sion1223/temi-tranformation-v2/robotemi_official/Proxy-Launcher/README.md

A proxy app launcher

Supported app

| App | Key | Value |
|---|---|---|
| Chrome | url | "https://www.robotemi.com" |
