sion1223/temi-tranformation-v2/basket/smart_lock_box_r3_lift/HARDWARE_ACCEPTANCE.md

# 실물 확인표

전 항목 **미실행**. CAD 계산을 합격으로 옮겨 적지 않는다.

|시험|확인할 내용|
|---|---|
|구매품 치수|PQ12 양끝 유효위치·핀간격·15mm높이·단자·케이블; MGN7C 홀피치; LM6UU; L6D 3kg 납품도면|
|모터 내부 수용|닫힘·승강 전 구간에서 모터·단자·케이블·관절이 케이스 밖으로 나가지 않음|
|조립 정렬|네롤러 동시 접촉, 레일·수직축 평행, 어느 위치에서도 구속/틀어짐 없음|
|빈판/500g|평균 전류·기동 전류·왕복시간·온도·완전하강·완전상승. 센서가 실제로 스톨 전에 종료시킴|
|편하중|종이500g 중앙 및4모서리·프레임처짐·가이드 마찰·바닥 수평|
|전원상실|어느 높이에서도 예기치 않은 급강하 여부, 정지상태 유지. 단전시 손으로 밑을 받치지 않고 별도 기계 지지로 정비|
|과부하·끼임|전류제한·6초시간제한·요청해제시 정지·한쪽스위치만 감지·안전한 수동 회수|
|센서 고장|UP/DOWN단선·단락·I2C정지·FAULT·리셋·저전압·통신단절에서 승강/주행 금지|
|계량|하강안착/모터OFF후3초,5g분동9지점×10회, A4한장 반복,30분영점드리프트|
|가드·배선|종이·손·케이블이 램프/가이드에 닿지 않음, 계량판에 케이블 당김 없음, 보호판 고정나사 접근|
|듀티|제조사20% 이하,최대6초ON이면24초이상OFF. 실제 발열·시간 기록|
|잠금·도어|R3순서로 개방/격납/닫기; 올라온 바닥 상태에서 닫기 방지|
|테미|108mm케이스와 열림도어의 헤드·시야·센서·주행 간섭,장착강도·전원·최대총중량|

기존 R3 펌웨어는 승강 제어와 이 표의 고장대응이 통합되기 전 실물 자동운전에 사용하지 않는다.
