sion1223/temi-tranformation-v2/basket/smart_lock_box_r3/HARDWARE_ACCEPTANCE.md

# 실물 승인 시험 — 아직 수행하지 않음

이 파일의 빈 항목 또는 `NOT_RUN`을 합격으로 바꾸지 않는다. `hardware_measurements.csv`에 실측값을 기록한다. 현재 결과는 컴퓨터 기하 검사와 소프트웨어 모의 시험까지다.

1. 구매품 치수: L6D 3 kg의 제조사 도면·체결 방향·가동단·M6 피치/나사 길이, 5065 스트로크, 두 레버 스위치, HX711 보드의 실제 AVDD/E+, BLE 공급/신호전압 확인. 도면과 다르면 모델·배선부터 수정한다.
2. 하중 경로: 상판 전체와 라이너/스페이서의 사하중 기록. 상판을 누르지 않을 때 스토퍼와 보호판 모두 비접촉. 가동단 이외에 하중이 전달되는 지점이 없어야 한다. 최대 하중에서 틈을 실측하고 스토퍼 심을 조정한다. 0.8 mm라는 CAD 간격으로 과부하 안전을 판정하지 않는다.
3. 센서 보정: 최소 15초 초기 대기 후 빈 판과 추적 가능한 500 g 분동으로 보정. 케이블/패널 정비, 판 교체, 조립 토크 변경 뒤 재시험한다.
4. 5 g 분동: 판의 중앙, 네 변 중간, 네 모서리 안쪽의 총 9지점에 각 10회 적재·회수. 최소 90회 모두 검출, 회수 후 비적재 복귀. 프레임 평균 무게, 창 내 최대-최소, 지연, 실패를 기록한다. 검출 지연 목표는 정지·안정 조건 충족 후 5초 이내다.
5. 실제 A4 80 g/㎡ 한 장: 실제 질량을 기준 저울로 먼저 측정. 평평한 종이를 판 밖/벽/키퍼에 걸치지 않고 9개 유효 배치(미세 위치 이동)에 각각 10회 적재·회수한다. 90회 모두 검출해야 한다. 종이 구김·말림과 실제 실내 공기 흐름 조건도 별도 확인한다.
6. 빈 판 드리프트: 30분 동안 1초 간격 기록, 종이를 올렸다 내리는 과정 포함. 빈 판이 3 g 임계값에 접근하거나 0.8 g 안정 창을 계속 만족하지 못하면 불합격. 최소 목표는 빈 판 ±1 g 이내, 안정 창 0.8 g 이내. 자동 영점으로 이 실패를 숨기지 않는다.
7. 로봇 진동: 정지 상태에서만 유효 무게를 내며 이동·회전·급정지·도어 조작·솔레노이드 동작 중에는 INVALID. 완전 정지 이후 새 20샘플을 받은 뒤에만 다시 유효. 로봇의 실제 상태를 기반으로 heartbeat를 보낼 앱이 필요하다.
8. 재부팅: A4 한 장을 둔 채 전원 20회 재인가. 보정이 사라지거나 물건을 빈 판으로 잡으면 실패. 키/EEPROM 부팅 번호 저장 중 전압이 떨어져도 이전 인증 응답이 재사용되면 실패. BOD 설정·watchdog 복구를 실제 보드에서 확인한다.
9. 고장 주입: DOUT 단선/단락, 셀 브리지 단선/쇼트, 센서 전원 단절, 리드/레버 단선, 전면 패널 및 보호판 분리, 정지 heartbeat 단절, 인증 변조/재전송. 오류 시 해제 금지·코일 차단·무효 무게·이동 시작 거부를 확인한다. 모든 종류의 로드셀 브리지 고장이 자동 검출된다고 가정하지 않는다.
10. 잠금·닫기: 무전원 잠김 확인. 전진 스위치가 정상이어도 키퍼에 실제 물림이 없으면 불합격. 명령 후 500 ms 안에 후퇴, 후퇴 간격 ≥0.3 mm, 명령 닫기 후 전진·문 닫힘 동시 확인. 스프링 캠에 의존한 강제 닫힘은 승인하지 않는다. 명시한 목표 인장하중을 먼저 결정하고 100회 이상의 잠금/해제 및 인장 시험을 실시한다.
11. 코일·전원: 전류 제한된 12 V로 시작. 2초 ON/6초 OFF 반복 시 코일/드라이버/배선 온도, 5 V/HX711 잡음, 최저 입력에서 후퇴력을 측정. 퓨즈는 코일 과열 보호기가 아니다. Timer1/WDT, MCU 정지, 전원 재부팅 후 최소 휴지시간도 실제 확인한다.
12. 테미 장착: 폭 증가 12 mm, 총중량, 격납 돌출 174.2 mm, 헤드의 모든 자세, 체결판·케이블·수동 서비스 해제 접근을 검사. 현재 로봇 장착 좌표와 헤드 모델이 연결돼 있지 않아 CAD 합격 범위에 포함하지 않았다.

최대 적재 무게, 목표 잠금 인장하중, 배터리 자립 시간은 사용자 미정 사항이다. 이 셋을 정하지 않은 채 제조 승인이나 성능 보증을 하지 않는다.
