sion1223/temi-tranformation-v2/.sites-design-options/option-a.html

temi Head 3D Library

모델 준비됨

공유 링크 ⓘ

↻ ✥ ⌕ ⌗ ◩

PERSPECTIVE · SHADED1 unit = 1 mm · Z-UP

Head_2.0.33 / 전체 조립체선택: Main Head Shell · 148,290 faces

XYZ

LMB회전SHIFT이동SCROLL확대

Assembly navigator

## 부품 탐색기

12개 메시

⌕

▼Head_2.0.33ASSEMBLY · 12 PARTS◉

Main Head ShellOBJ · 148,290 FACES◉

Face Screen BezelOBJ · 32,144 FACES◉

▶Side Sensor HousingGROUP · 2 PARTS◉

Sensor Ring — LSTL · 8,432 FACES◉

Sensor Ring — RSTL · 8,432 FACES◉

Lower Chin CoverOBJ · 19,608 FACES◉

Neck AdapterSTL · 24,190 FACES◉

Top PlateSTL · 11,076 FACES◉

Main Head Shell선택됨

크기286 × 248 × 224 mm

용량18.42 MB

버텍스74,208

형식Wavefront OBJ

선택 부품 다운로드 ↓

### 원본 제작 파일

Blender와 3D 프린팅 도구에서 바로 열 수 있는
검증된 원본 파일입니다.

OBJ

Reference AssemblyBlender 조립체 · 163.37 MB

↓

STL

All Components전체 출력 부품 · 81.99 MB

↓

3MF

Bambu Printfile슬라이서 프로젝트 · 22.33 MB

↓
