sion1223/temi-tranformation-v2/.sites-design-options/option-b.html

temi HEAD LIBRARYOPEN HARDWARE ARCHIVE

HEAD α2.0.33 · ASSEMBLY 001
UPDATED 2026.07.21 / KR

Interactive component archive / 01—33

# temi Head 3D Library

로봇 헤드를 부품 단위로 살펴보세요.드래그하여 회전하고, 메시를 선택해 숨기거나 개별 다운로드할 수 있습니다. 원본 제작 파일도 그대로 제공합니다.

부품 목록 18

부품 이름 검색

01외부 쉘 02전면 센서 링 03카메라 하우징 04좌측 스피커 커버 05우측 스피커 커버 06하단 턱 플레이트 07넥 마운트 08내부 브래킷 A 09내부 브래킷 B

전체 표시18 / 18

솔리드와이어분해도

PERSPECTIVE · FRONT 3/4

드래그 회전휠 확대클릭 선택

선택 항목 02 / 18

MESH_002

### 전면 센서 링

재질ABS / BLACK크기Ø 84 mm폴리곤12,480파일STL · 3.8 MB

메시 표시

선택 강조

치수 가이드

선택 부품 다운로드 ↓

PART FILTER전체 18외장 6센서 3구조 5마운트 4● 3D 미리보기 준비됨

Original source

## 전체 모델 다운로드

제작자가 제공한 원본 파일입니다.
라이선스 및 버전 정보를 확인하세요.

OBJ

REFERENCE ASSEMBLY

### 원본 조립 모델

163.37 MB · Blender 호환

↓

STL

ALL COMPONENTS

### 전체 출력 부품

81.99 MB · Binary STL

↓

3MF

BAMBU PRINT FILE

### 프린트 프로젝트

22.33 MB · Bambu Studio

↓

다운로드 준비 중입니다.
