sion1223/temi-tranformation-v2/.sites-design-options/option-c.html

temiHEAD 3D LIBRARY

● WEBGL READYKR⌄

Digital Artifact / 033

# HEADARCHIVE

On display

temi Head Assembly
Alpha 2.0.33

REF_ASSEMBLY_OBJ

구성 요소18 MESHES

정점2,481,903

스케일1:1 / mm

↻✥＋⌗

원본 파일03 FILES

OBJReference Assembly163.37 MB · 조립 원본↓ STLAll Components81.99 MB · 프린트 메시↓ 3MFBambu Printfile22.33 MB · 슬라이서 프로젝트↓

선택한 부품 다운로드 ↓

CURRENT SELECTION

### Face Frame Assembly

FACE_FRAME_A · 14.82 MB

단독 보기정보 열기

DRAG TO ROTATE · SCROLL TO ZOOM · SHIFT + DRAG TO PAN

부품 인벤토리 18

전체외장프레임브래킷전자부품

패널 접기⌄

01 / SELECTED

Face Frame

FACE_FRAME_A

◉

02

Side Frame L

SIDE_FRAME_L

◉

03

Top Cover

TOP_COVER_01

◉

04

Camera Mount

CAM_MOUNT_B

◉

05

Neck Bracket

NECK_BRKT_02

◉

06

Rear Shell

REAR_SHELL_C

◉
