sion1223/temi-tranformation-v2/temi robotemi GitHub 비개발자 설명서.docx

처음 보는 사람을 위한 현장 안내서

robotemi GitHub, 이렇게 보면 됩니다

프로그래밍 언어를 몰라도 프로젝트의 구조·준비물·진행 순서를 이해하는 설명서

기준일: 2026년 7월 16일

대상: 프로젝트 책임자, 교사, 운영자, 입문자

공식 기준: robotemi GitHub / SDK 1.138.0

# 이 설명서로 할 수 있는 것

- GitHub 화면에서 무엇을 눌러야 하는지 구분할 수 있다.
- robotemi의 5개 저장소 중 우리 프로젝트에 필요한 것을 고를 수 있다.
- 개발자에게 무엇을 요청하고 무엇을 확인해야 하는지 알 수 있다.
- 샘플 앱을 로봇에서 실행하는 전체 순서를 이해할 수 있다.
- 실패했을 때 버전·연결·권한·Kiosk 중 어디를 먼저 볼지 판단할 수 있다.

중요 이 문서는 코드를 직접 작성하는 교재가 아니라, 공식 예제를 안전하게 실행하고 개발자와 같은 그림을 보도록 돕는 운영 안내서다.

# 1. GitHub가 무엇인가요?

GitHub는 프로그램의 설계도, 설명서, 변경 기록을 함께 보관하는 온라인 작업실이다. robotemi 링크는 temi 제조사가 공개한 공식 개발 자료 모음이다.

화면의 말 | 쉬운 뜻 | 여기서 할 일
Repository | 한 프로젝트의 자료함 | sdk 저장소를 연다
README | 첫 안내문 | 목적·버전을 확인한다
Code | 프로그램 파일 | 직접 수정은 개발자에게 맡긴다
Wiki | 사용 설명서 | 설치·음성·이동·권한을 읽는다
Release | 버전별 변경 기록 | 로봇 Launcher와 맞는지 본다
Sample | 작동 예제 | 처음부터 새로 만들지 말고 기준으로 삼는다
Issue | 질문·오류 게시판 | 공식 문서에 없는 현상을 검색한다
Clone/Download | 자료를 내 컴퓨터로 복사 | 개발자가 프로젝트를 내려받는다

# 2. robotemi 저장소 5개 이해하기

이름 | 비유 | 우리 프로젝트에서
sdk | 로봇 운전면허+설명서 | 반드시 사용. 이동·말하기·듣기·상태 확인
sample-app-media | 카메라/마이크 실습실 | 미디어 기능이 필요한 단계에서 참고
temi-Go | 배송 서비스 완성 예 | 서류함 목적지 배정·도착 화면 참고
Proxy-Launcher | 다른 앱을 여는 리모컨 | 현재는 필요 없음
TemiGoProSDK | Temi-Go-Pro 전용 리모컨 | 해당 장치가 있을 때만 사용

한 줄 결론 처음에는 sdk의 README·Wiki·sample 세 곳만 보면 된다. 나머지는 기능이 필요해졌을 때 연다.

# 3. 이 프로젝트가 실제로 어떻게 움직이나요?

1. 방문객이 화면의 '말하기' 버튼을 누르거나 로봇을 깨운다.
2. temi가 말을 듣고 글자로 바꾼다.
3. 글자가 Jetson이라는 작은 AI 컴퓨터로 전달된다.
4. Jetson이 직원 목록에서 사람과 방을 찾고, 필요하면 외부 AI에 질문한다.
5. Jetson이 '행정실 앞'처럼 미리 승인된 장소 이름을 temi 앱에 돌려준다.
6. temi가 안내 문장을 말하고 저장된 장소로 이동한다.
7. 담당자에게 방문 알림을 보낸다.

안전 장치 AI가 임의의 좌표를 만들게 하지 않는다. 로봇에 미리 저장된 장소 이름 중에서만 선택하게 한다.

# 4. 시작 전에 확인할 것

확인 항목 | 어디서 확인? | 기록 예
temi 기종 | 제품 라벨/설정 | V2 또는 V3
Launcher 버전 | temi 설정의 시스템 정보 | 138 / 빌드 19627 이상
Wi‑Fi | temi와 PC 네트워크 | 같은 공유기
개발 PC | Windows/Mac | Android Studio 설치 가능
권한 | 설정→Developer Tools | ADB Port Opening 가능
안전 공간 | 사람 없는 시험 구역 | 정지 버튼 담당자 지정

공식 Wiki 기준으로 temi V2는 Android 6.0.1(API 23), V3는 Android 11(API 30)이다. 같은 앱이라도 카메라·마이크·권한 반응이 다를 수 있으므로 기종을 반드시 기록한다.

# 5. 샘플 앱을 로봇에서 실행하는 순서

## 5.1 개발자에게 준비를 요청하세요

8. Android Studio와 ADB(Android Debug Bridge)를 PC에 설치한다.
9. https://github.com/robotemi/sdk 에서 Code → Download ZIP 또는 git clone으로 자료를 받는다.
10. Android Studio에서 sdk 폴더를 프로젝트로 연다.
11. README에 적힌 SDK 버전 1.138.0을 사용하도록 확인한다.
12. Gradle 동기화가 끝날 때까지 기다리고 sample 모듈을 빌드한다.

## 5.2 temi와 PC를 연결하세요

13. temi와 PC를 같은 Wi‑Fi에 연결한다.
14. temi에서 Settings → temi Developer Tools → ADB Port Opening을 누른다.
15. 화면에 표시된 temi의 IP 주소를 적는다.
16. PC의 터미널/명령 프롬프트에서 adb connect <IP주소>:5555를 실행한다.
17. Android Studio의 실행 장치에 rockchip rk... 또는 temi가 보이는지 확인한다.
18. sample 앱을 Run으로 실행한다.

성공 화면 temi의 앱 목록에 샘플 앱 이름이 보이고, 앱을 열었을 때 버튼이 나타나면 1차 성공이다.

# 6. 앱이 temi 앱 목록에 보이게 하는 표시

개발자는 AndroidManifest.xml이라는 앱 신분증에 SKILL 메타데이터를 넣어야 한다. 이것은 '이 앱을 temi 앱 목록에 보여 주세요'라는 표지다.

<meta-data android:name="com.robotemi.sdk.metadata.SKILL" android:value="@string/app_name" />

운영자는 코드를 외울 필요가 없다. 다만 앱이 목록에 없을 때 개발자에게 'Manifest의 SKILL 메타데이터와 onRobotReady 처리를 확인해 주세요'라고 요청하면 된다.

# 7. 장소를 준비하고 이동을 시험하는 법

19. temi 기본 기능으로 지도를 만들고 home base를 설정한다.
20. 복도·회의실 앞·행정실 앞처럼 실제 멈출 지점을 저장한다.
21. 장소 이름은 짧고 중복 없이 정한다. 예: '행정실 앞', '회의실 A'.
22. 샘플 앱에서 저장된 위치 목록이 보이는지 확인한다.
23. 사람 없는 곳에서 가장 느린 속도로 한 장소씩 goTo를 시험한다.
24. 이동 중 화면에 상태가 표시되고, 정지 버튼이 즉시 작동하는지 확인한다.
25. 20회 시험 결과를 기록한다. 실패하면 장소 이름, 시간, 장애물, 오류 상태를 함께 적는다.

하지 말 것 첫 시험에서 후진, 최고 속도, 혼잡한 복도, 임의 좌표 이동을 사용하지 않는다.

# 8. 듣기·말하기 기능을 이해하는 법

기능 | 쉬운 뜻 | 공식 SDK에서
Wakeup | 듣기 시작 | 앱이 wakeup()을 호출할 수 있음
ASR/STT | 음성을 글자로 변환 | AsrListener로 결과를 받음
NLU/LLM | 문장의 뜻을 판단 | 기본 기능 또는 Jetson AI 사용
TTS | 글을 음성으로 읽기 | speak() 또는 별도 TTS 서비스
Conversation status | 듣는 중/생각 중/말하는 중 | 화면 상태 표시용

기존 계획처럼 처음부터 마이크를 직접 녹음할 필요는 없다. 먼저 공식 wakeup→ASR→speak 흐름을 시험한다. 실제 로비 소음에서 품질이 부족할 때만 외부 STT/TTS로 교체한다.

# 9. Kiosk Mode는 무엇인가요?

Kiosk Mode는 우리 앱을 temi의 기본 홈 화면으로 지정하는 기능이다. 앱이 계속 앞에 있어야 하거나, temi의 기본 음성 흐름을 바꿔야 할 때 사용한다.

26. 개발자가 Manifest에 KIOSK=true를 선언한다.
27. 앱을 설치하고 실행한다.
28. temi Settings → Home Screen/Application 또는 Kiosk 메뉴로 이동한다.
29. 우리 앱을 선택하고 Kiosk를 켠다.
30. 앱에서 Kiosk 선택 여부와 켜짐 상태를 확인한다.
31. 운영자는 반드시 Kiosk 해제 방법을 먼저 연습한다.

주의 Kiosk는 앱에 더 큰 제어 권한을 준다. 시험용 앱을 운영 로봇의 기본 앱으로 바로 지정하지 않는다.

# 10. Jetson은 왜 필요한가요?

Jetson은 temi 옆에서 일하는 별도 AI 컴퓨터다. 로봇의 바퀴를 직접 움직이는 대신, 문장의 뜻을 판단하고 직원 정보를 찾고 외부 AI 키를 안전하게 보관한다.

temi 앱이 맡는 일 | Jetson이 맡는 일
화면과 버튼 | 직원·부서 검색
듣기/말하기 상태 표시 | AI 의도 분석
저장 장소로 이동 | 클라우드 API 키 보관
도착/실패 상태 전달 | 담당자 알림
비상 정지 UI | 서류함 모터 제어(2차)

보안 원칙 OpenAI·Gemini 같은 API 키는 temi 앱 안에 넣지 않는다. 앱 파일은 분석하면 내용이 보일 수 있으므로 Jetson에만 저장한다.

# 11. 서류함을 붙일 때의 안전 순서

32. 먼저 앱과 이동 기능을 완성한다.
33. 본체를 열지 않고, 독립 전원을 쓰는 탈착식 서류함을 만든다.
34. 서보모터에는 별도 5V 전원과 보호 장치를 사용한다.
35. 끼임 방지, 수동 개방, 열, 반복 개폐를 시험한다.
36. 추가 무게를 실은 상태로 저속 정지거리와 회전을 시험한다.
37. 제조사·판매사와 전기/기구 담당자의 승인을 받은 뒤 내부 통합을 검토한다.

공식 범위 robotemi GitHub는 앱 개발 자료다. 본체 내부 배터리 배선과 기구 개조를 공식적으로 보장하는 설명서는 아니다.

# 12. 문제가 생기면 이 순서로 확인

증상 | 먼저 볼 것 | 개발자에게 할 말
앱이 목록에 없음 | SKILL 메타데이터 | Manifest와 onRobotReady 확인
PC에서 로봇이 안 보임 | 같은 Wi‑Fi, ADB Port | adb connect IP:5555 재확인
버튼을 눌러도 이동 안 함 | robot ready, 장소 이름 | robot.locations와 정확히 일치 확인
말을 못 들음 | Kiosk, 음성 상태, 기종 | wakeup/AsrListener 로그 확인
말하지 않음 | TTS 상태 | speak 또는 ITtsService 상태 발행 확인
특정 API만 실패 | SDK와 Launcher | 1.138.0/Launcher 138 호환 확인
이동이 중단됨 | 장애물·지도 유실 | GoTo 상태 코드와 시간 기록
Jetson 응답 없음 | 전원·IP·/health | 타임아웃 후 안전 강등 확인

# 13. 개발자에게 넘길 요구사항

- 기종과 Launcher 빌드가 적힌 버전표를 제출해 주세요.
- SDK 1.138.0 기준으로 빌드하고, 바뀌면 이유를 기록해 주세요.
- Robot ready, 이동 상태, 음성 상태, 네트워크 오류를 로그로 남겨 주세요.
- 목적지는 robot.locations 목록에 있는 이름만 허용해 주세요.
- 정지 버튼과 Kiosk 해제 절차를 먼저 구현해 주세요.
- API 키가 APK와 GitHub에 없는지 검사해 주세요.
- 오디오·얼굴 데이터를 저장한다면 목적과 보존기간을 먼저 승인받아 주세요.
- 샘플 앱에서 확인한 기능을 한 번에 하나씩 본 앱으로 옮겨 주세요.

# 14. 운영자 최종 체크리스트

- [ ] 로봇 기종과 Launcher 빌드를 기록했다.
- [ ] 샘플 앱이 설치되고 앱 목록에 보인다.
- [ ] 저장 장소와 home base가 준비됐다.
- [ ] 저속 이동·정지·복귀를 시험했다.
- [ ] wakeup→듣기→말하기가 작동한다.
- [ ] Kiosk를 켜고 끄는 방법을 안다.
- [ ] 네트워크가 끊기면 안전하게 멈춘다.
- [ ] 담당자 정보와 목적지 이름이 일치한다.
- [ ] 개인정보 저장 여부와 보존기간이 승인됐다.
- [ ] 물리 개조는 별도 안전 승인 전 시작하지 않는다.

# 15. 쉬운 용어 사전

용어 | 뜻
Android | temi 태블릿에서 앱이 실행되는 운영체제
Kotlin/Java | Android 앱을 만드는 프로그래밍 언어
SDK | 앱이 로봇 기능을 쓰게 해 주는 공식 도구 상자
API | 프로그램끼리 정해진 형식으로 부탁하는 창구
APK | Android 앱 설치 파일
ADB | PC와 Android 장치를 연결·설치·점검하는 도구
Gradle | 앱에 필요한 부품을 모아 빌드하는 도구
Manifest | 앱 이름·권한·temi 기능을 적는 신분증
Listener | 로봇 상태가 바뀌면 알려 주는 알림 수신기
Kiosk | 우리 앱을 기본 홈 화면으로 고정하는 모드
STT/ASR | 사람의 말을 글자로 바꾸는 기능
TTS | 글을 음성으로 읽는 기능
LLM | 문장의 뜻을 해석하고 답을 만드는 AI
Jetson | 로봇 밖에서 AI·DB·모터 제어를 담당하는 소형 컴퓨터
GPIO | Jetson이 센서·서보와 전기 신호를 주고받는 핀

# 16. 공식 링크

robotemi 전체: 공식 페이지 열기 (https://github.com/robotemi)

temi SDK: 공식 페이지 열기 (https://github.com/robotemi/sdk)

SDK Wiki: 공식 페이지 열기 (https://github.com/robotemi/sdk/wiki)

설치/ADB: 공식 페이지 열기 (https://github.com/robotemi/sdk/wiki/Installing-and-Uninstalling-temi-Applications)

Kiosk: 공식 페이지 열기 (https://github.com/robotemi/sdk/wiki/Kiosk-Mode)

Speech: 공식 페이지 열기 (https://github.com/robotemi/sdk/wiki/Speech)

Locations: 공식 페이지 열기 (https://github.com/robotemi/sdk/wiki/Locations)

Permission: 공식 페이지 열기 (https://github.com/robotemi/sdk/wiki/Permission)

Media sample: 공식 페이지 열기 (https://github.com/robotemi/sample-app-media)

temi-Go: 공식 페이지 열기 (https://github.com/robotemi/temi-Go)

temi 공식 GitHub 비개발자 설명서
