sion1223/temi-tranformation-v2/temi 로봇 AI 개조 프로젝트 최종 계획서 v2.0 (robotemi 공식자료 반영).docx

최종 실행 계획서 · 공식자료 반영본

temi 기반 AI 방문객 안내·서류 운반 시스템

robotemi 공식 GitHub와 SDK Wiki 기준으로 기술 가정을 교정한 실행 계획

버전: v2.0

기준일: 2026년 7월 16일

공식 기준 SDK: 1.138.0 / temi 138 Launcher 최소 빌드 19627

# 0. 수정 결론

최종 권고 1차 목표는 로봇을 분해하는 것이 아니라 공식 Android SDK로 안내 앱을 완성하는 것이다. Jetson은 외부 AI 서버로 연결하고, 전원 분기·프레임 개조·서류함은 소프트웨어 MVP가 통과한 뒤 별도 안전 승인 단계에서 진행한다.

기존 v1.0의 전체 목표는 유지하되, 공식 자료와 충돌하거나 검증되지 않은 가정을 아래처럼 수정한다.

항목 | v1.0 가정 | v2.0 결정
음성 시작 | wakeup()으로 직접 STT 시작이 막힘 | 공식 wakeup()과 ASR 리스너를 우선 사용
STT 교체 | AudioRecord+VAD를 즉시 구현 | 기본 음성 흐름 검증 후 Kiosk 기반 STT 재정의를 선택
TTS 교체 | Manifest 선언만으로 교체 | OVERRIDE_TTS + ITtsService + setTtsService + 상태 발행까지 구현
SDK 기준 | 버전 기준 불명확 | SDK 1.138.0, Launcher 138/19627 기준 고정
물리 개조 | 앱 개발과 동시에 진행 | 공식 SDK 범위 밖이므로 별도 승인·전기·주행 안전 게이트 적용

# 1. 프로젝트 목표와 범위

## 1.1 최종 목표

- 방문객의 말을 듣고 방문 목적·담당자·목적지를 파악한다.
- 직원/부서 데이터베이스를 조회하고 담당자에게 알림을 보낸다.
- temi에 미리 저장된 위치를 이용해 목적지까지 자율 안내한다.
- 네트워크 장애 시 최소 안내·안전 정지·사람 호출 기능을 유지한다.
- 2차 단계에서 잠금 가능한 서류함을 장착하고 Jetson GPIO로 제어한다.

## 1.2 범위 구분

구분 | 포함 | 이번 계획에서 제외/게이트
MVP | Android 안내 앱, temi 이동, 기본 음성, Jetson API, 직원 DB, 알림 | 물리 분해, 배터리 직접 분기
확장 | 외부 STT/TTS, 로컬 LLM, 다층 지도, 카메라 | 얼굴 인식은 개인정보 검토 전 금지
하드웨어 | 외장형 Jetson·독립 전원·탈착식 서류함 시제품 | 내부 배선 변경은 제조사/전문가 승인 후

# 2. 공식 robotemi 자료 기준

2026년 7월 16일 확인 기준, robotemi 조직은 5개 공개 저장소를 제공한다. 본 프로젝트의 주 기준은 sdk이며, 나머지는 특정 기능을 이해하기 위한 예제 또는 별도 제품용 자료다.

저장소 | 프로젝트에서의 의미 | 사용 결정
sdk | 공식 Android SDK, 문서, 전체 샘플 | 필수 기준선
sample-app-media | 카메라·마이크·스트리밍 예제 | 미디어 검증 때 참조
temi-Go | Kotlin/Compose 기반 물품 배송 앱 | 서류 운반 UX 참고
Proxy-Launcher | temi에서 다른 앱을 여는 프록시 | 현재 MVP에는 불필요
TemiGoProSDK | Temi-Go-Pro 제어용 별도 SDK | 해당 하드웨어 보유 시에만

호환성 고정 SDK 1.138.0은 temi 138 Launcher 및 최소 빌드 19627과 함께 검증한다. 다른 Launcher에서는 지원되지 않는 기능이 생길 수 있으므로 버전 확인 전 개발을 시작하지 않는다.

공식 Wiki는 temi V2 태블릿이 Android 6.0.1(API 23), V3 태블릿이 Android 11(API 30)이라고 안내한다. 따라서 최소 Android 버전, 런타임 권한, 카메라/마이크 동작을 기종별로 각각 시험한다.

# 3. 확정 시스템 아키텍처

계층 | 책임 | 통신/경계
temi Android 앱 | 화면, 대화 상태, TTS 재생, 위치 선택, goTo 실행, 이동 상태 표시 | temi SDK로만 로봇 기능 호출
Jetson API | 의도 분류, 직원 조회, 클라우드 API 프록시, 로컬 LLM, 서류함 제어 | HTTPS 또는 격리된 로컬망
클라우드 | 선택적 STT/TTS/LLM | 키는 Jetson에만 보관
데이터 | 직원·부서·연락처·temi 저장 위치명 | 최소 권한, 변경 이력, 백업
하드웨어 확장 | 서류함·센서·서보 | 독립 전원, 공통 접지·보호회로는 전문가 검토

데이터 흐름: 방문객 발화 → temi 음성 흐름 또는 외부 STT → Jetson 의도/DB 조회 → 승인된 목적지 반환 → 담당자 알림 → temi TTS → goTo(저장 위치명) → 상태 콜백으로 화면/알림 갱신

# 4. 음성·AI 설계

## 4.1 단계 A: 공식 음성 흐름으로 MVP

- 앱에서 robot.wakeup()을 호출해 듣기를 시작한다.
- AsrListener 또는 OnConversationStatusChangedListener로 인식 텍스트와 상태를 받는다.
- 인식된 텍스트만 Jetson으로 보내 개인정보와 대역폭을 줄인다.
- 응답은 우선 robot.speak(TtsRequest)로 재생한다.
- Kiosk 선택 여부와 로봇 준비 상태(isReady/onRobotReady)를 확인한 뒤 기능을 활성화한다.

## 4.2 단계 B: NLU만 외부 AI로 교체

temi가 음성을 텍스트로 바꾸는 부분은 유지하고, 텍스트의 의미 해석과 담당자 검색만 Jetson의 규칙 엔진·로컬 LLM·클라우드 LLM에 맡긴다. 가장 구현 위험이 낮고, MVP에 권장되는 조합이다.

## 4.3 단계 C: STT/TTS 완전 재정의

- 기본 STT 품질이 실제 로비에서 목표에 미달할 때만 STT 재정의를 진행한다.
- Kiosk 앱 선언과 OVERRIDE_STT 메타데이터를 적용하고 공식 Wakeup/ASR 연결점을 따른다.
- TTS 교체 시 OVERRIDE_TTS, ITtsService 구현, setTtsService 바인딩, publishTtsStatus 상태 보고를 모두 구현한다.
- AudioRecord+VAD는 공식 재정의 흐름으로 요구 성능이 나오지 않을 때의 마지막 대안이다.
- sample-app-media는 미디어 접근 가능성을 확인하는 참고 예제이며, 최신 SDK 1.138.0으로 올린 뒤 회귀 테스트한다.

# 5. 이동·지도 설계

- 목적지는 좌표를 LLM이 생성하게 하지 않고 temi에 저장된 위치명 목록에서만 선택한다.
- 실행 전 robot.locations에 목적지가 존재하는지 확인한다.
- goTo(location, backwards, noBypass, speedLevel, highAccuracyArrival, noRotationAtEnd)를 사용한다.
- SDK 137+의 VERY_SLOW(0.3 m/s), SLOW(0.5), MEDIUM(0.7), HIGH(0.9), VERY_HIGH(1.2)을 시험한다. 로비 기본값은 VERY_SLOW 또는 SLOW로 시작한다.
- SDK 136+ customSpeed는 0.1~1.5 m/s를 받지만 실제 상한은 기종·바닥·장애물 회피 조건에 따라 낮을 수 있다.
- OnGoToLocationStatusChangedListener를 통해 출발·계산·이동·도착·중단·오류를 기록하고 UI에 표시한다.
- 지도 데이터 자체를 읽거나 수정할 때만 MAP 권한을 요청한다. 단순 저장 위치 이동은 별도 MAP 권한이 필요하지 않다.

안전 기본값 사람이 많은 실내에서는 저속, 전진 이동, 장애물 우회 허용을 기본으로 한다. 후진·수동 skidJoy는 시험 구역 외에서 사용하지 않는다.

# 6. Jetson·백엔드·데이터

## 6.1 Jetson 역할

- FastAPI 또는 동등한 REST 서버로 /health, /intent, /people/search, /notify, /box/open, /box/close를 제공한다.
- API 키와 DB 자격 증명은 환경변수/시크릿 저장소에 두고 APK에는 넣지 않는다.
- 로컬 LLM은 모델명을 계획서에 고정하지 않고, 8GB 메모리에서 실제 지연·정확도·발열 시험을 통과한 양자화 모델을 채택한다.
- 클라우드 호출 실패 시 규칙 기반 FAQ와 사람 호출로 안전하게 강등한다.

## 6.2 직원 데이터 최소 스키마

필드 | 예 | 규칙
person_id | EMP-001 | 이름 대신 내부 식별자로 연결
display_name | 김민준 | 동명이인 처리 필요
department | 행정실 | 검색·안내 문구용
temi_location | 행정실 앞 | robot.locations와 정확히 일치
notification_target | 웹훅/내선 | 앱에는 노출하지 않음
active | true | 퇴직·부재 시 즉시 비활성

# 7. 서류함·전원·기구 설계 게이트

robotemi 공개 GitHub는 Android 앱과 SDK 사용법을 제공하지만, temi 본체 내부 배터리 분기·기구 개조 방법을 공식 지원 범위로 제시하지 않는다. 따라서 아래 순서 없이는 본체를 열거나 배선을 변경하지 않는다.

1. 제조사/판매사에 보증, 서비스, 개조 허용 범위를 서면 확인한다.
2. Jetson과 서보를 독립 배터리로 구동하는 외장형 시제품을 먼저 만든다.
3. 추가 질량, 무게중심, 정지거리, 회전 안정성, 충돌 위험을 시험한다.
4. 전기 담당자가 전압·최대전류·퓨즈·역극성·접지·EMI를 검토한다.
5. 탈착식 브래킷과 수동 비상 개방 장치를 적용한다.
6. 모든 시험을 통과한 뒤에만 내부 전원 통합 여부를 재결정한다.

부품군 | MVP | 통합 단계
컴퓨팅 | Jetson Orin Nano 8GB + NVMe SSD | 방열·부팅 복구 시험
전원 | 인증된 독립 전원 | 본체 전원 분기는 승인 후
구동 | 서보 1개 또는 PCA9685 | 전원 분리·퓨즈·리미트 스위치
기구 | 탈착식 경량 서류함 | 주행 안정성 시험 후 고정
통신 | 동일 Wi‑Fi 우선 | 필요 시 USB‑Ethernet 검증

# 8. 단계별 개발 로드맵

단계 | 핵심 작업 | 완료 기준
0. 기준선 (1주) | 기종·Launcher·SDK 고정, 샘플 앱 실행, 위치 3개 저장 | 앱 표시·robot ready·goTo 왕복 성공
1. 이동 MVP (1주) | 위치 목록, 이동 버튼, 상태·정지 UI | 20회 중 19회 이상 정상 도착, 모든 실패 기록
2. 음성 MVP (1~2주) | wakeup, ASR, speak, 대화 상태 | 조용한 환경 핵심 문장 인식률 90% 이상
3. Jetson 연동 (2주) | API, 직원 DB, 알림, 키 보호 | 인터넷 단절 시 안전 강등, 비밀정보 APK 미포함
4. 로비 검증 (2주) | 소음·다인·네트워크·장애물 시험 | 업무 문장 성공률 85% 이상, 응답 중앙값 3초 이내
5. 음성 재정의 (선택) | 외부 STT/TTS A/B 시험 | 기본 흐름보다 유의미하게 개선될 때만 채택
6. 서류함 (2~4주) | 외장 전원·서보·센서·비상 개방 | 100회 개폐, 주행 안정성·열·전원 시험 통과
7. 운영 전환 (1주) | 로그, 관리자 매뉴얼, 복구 절차 | 담당자 승인·운영 체크리스트 완료

# 9. 시험 및 합격 기준

시험 | 측정값 | 초기 합격선
로봇 준비 | 부팅 후 isReady 도달 시간 | 5회 모두 준비 완료, 타임아웃 처리
이동 | 도착률·중단률·평균 시간 | 정상 경로 95% 이상
음성 | 문장 정확도·무응답·오인식 | 조용 90%, 로비 85% 이상
의도 | 담당자/목적지 정확도 | 승인된 테스트셋 95% 이상
지연 | 발화 종료→첫 응답 | 중앙값 3초, 95백분위 6초 이하
장애 | Wi‑Fi/API/DB 실패 | 안전 정지·재시도·사람 호출
보안 | APK 비밀정보·로그 개인정보 | 비밀정보 0건, 보존기간 준수
서류함 | 개폐·잠금·수동 해제 | 100회 반복, 끼임/과열 0건

# 10. 위험과 대응

위험 | 대응 | 중단 조건
SDK/Launcher 불일치 | 버전 매트릭스 고정, 실제 로봇 시험 | 핵심 API가 3회 연속 실패
음성 오인식 | 확인 질문, 목적지 화이트리스트 | 잘못된 이동 지시 발생
네트워크 장애 | 타임아웃, 로컬 FAQ, 사람 호출 | 응답 없는 상태 10초 초과
개인정보 노출 | 최소 수집, 마스킹, 짧은 보존 | 동의 없는 녹음/얼굴 저장
주행 위험 | 저속, 정지 버튼, 혼잡 시간 제한 | 충돌·들림·경로 유실
전기/열 위험 | 독립 전원, 퓨즈, 온도 모니터 | 과열·전압 불안정
LLM 환각 | 함수/목적지 화이트리스트, DB 검증 | 존재하지 않는 사람·장소 생성

# 11. 운영·보안·개인정보

- API 키는 Jetson 시크릿으로만 관리하고 GitHub·APK·로그에 기록하지 않는다.
- temi→Jetson 요청에는 장치 토큰, 요청 ID, 짧은 타임아웃, 재전송 중복 방지를 적용한다.
- 발화 원본은 기본적으로 저장하지 않고, 분석이 필요하면 동의·목적·보존기간을 명시한다.
- LLM 응답은 직접 이동 명령이 아니라 승인된 함수와 위치명 목록을 통해서만 실행한다.
- 관리자는 비상 정지, Kiosk 해제, 앱 재시작, 네트워크 단절 운영법을 숙지한다.

# 12. 역할과 산출물

역할 | 책임 | 산출물
프로젝트 책임자 | 범위·개인정보·현장 승인 | 요구사항, 합격 서명
Android 개발 | temi SDK·UI·음성·이동 | APK, 소스, 버전 매트릭스
백엔드/AI | Jetson API·DB·모델·알림 | 서버 이미지, API 명세, 테스트
하드웨어 | 전원·서보·기구·안전 | 회로도, BOM, 위험성 평가
운영 담당 | 위치·직원 DB·장애 대응 | 운영 설명서, 변경 기록

# 13. 공식 출처 및 기준일

아래 링크는 2026년 7월 16일 확인했다. SDK/Launcher 버전과 API는 변경될 수 있으므로 각 Phase 시작 시 다시 확인한다.

robotemi 조직: 공식 페이지 열기 (https://github.com/robotemi)

temi SDK: 공식 페이지 열기 (https://github.com/robotemi/sdk)

SDK Wiki: 공식 페이지 열기 (https://github.com/robotemi/sdk/wiki)

설치·ADB: 공식 페이지 열기 (https://github.com/robotemi/sdk/wiki/Installing-and-Uninstalling-temi-Applications)

Kiosk Mode: 공식 페이지 열기 (https://github.com/robotemi/sdk/wiki/Kiosk-Mode)

Speech: 공식 페이지 열기 (https://github.com/robotemi/sdk/wiki/Speech)

Locations: 공식 페이지 열기 (https://github.com/robotemi/sdk/wiki/Locations)

Permission: 공식 페이지 열기 (https://github.com/robotemi/sdk/wiki/Permission)

Media 샘플: 공식 페이지 열기 (https://github.com/robotemi/sample-app-media)

배송 샘플: 공식 페이지 열기 (https://github.com/robotemi/temi-Go)

# 부록 A. 개발 착수 체크리스트

- [ ] temi 기종(V2/V3)과 Launcher 빌드를 기록했다.
- [ ] SDK 1.138.0 기준 프로젝트가 빌드된다.
- [ ] 샘플 앱이 temi 앱 목록에 보인다.
- [ ] onRobotReady(true)를 확인했다.
- [ ] 위치 3개와 home base를 저장했다.
- [ ] 저속 goTo와 stopMovement를 시험했다.
- [ ] wakeup→ASR→speak 기본 흐름을 시험했다.
- [ ] Kiosk 해제·복구 방법을 운영자가 알고 있다.
- [ ] API 키가 APK/저장소에 없음을 확인했다.
- [ ] 물리 개조 전 제조사/전기/주행 안전 승인을 받았다.

temi AI 개조 프로젝트 | 최종 실행 계획서 v2.0
