sion1223/temi-tranformation-v2/temi 로봇 AI 개조 프로젝트 최종 계획서.docx

# temi 로봇 AI 개조 프로젝트 최종 계획서

프로젝트명: temi 기반 AI 방문객 안내·서류 운반 로봇 작성일: 2026년 7월 2일 버전: v1.0

## 1. 프로젝트 개요

### 1.1 목표

상용 서비스 로봇 temi를 분해·개조하여, 다음 기능을 갖춘 자율 방문객 안내 로봇을 제작한다.

- 방문객의 자연어 발화를 인식 (temi 내장 STT → OpenAI Whisper 교체)
- 발화 의도를 파악하고 목적지를 안내 (기존 전문가 시스템 → Gemini API + 로컬 Gemma 하이브리드 교체)
- 방문 목적에 맞는 담당자를 조회하고 담당자에게 알림 발송
- 목적지까지 자율 주행하며 안내
- (2차 목표) 서류 운반용 박스를 탑재하고 서보모터로 개폐 제어

### 1.2 핵심 설계 원칙

- API 키는 절대 앱(APK)에 직접 포함하지 않는다. 디컴파일로 노출되므로 반드시 서버(Jetson)를 경유한다.
- 하이브리드 추론: 단순 질의는 로컬 Gemma로 즉시 처리, 복잡한 의도 파악은 클라우드 Gemini로 위임하여 지연시간과 인터넷 의존도를 동시에 낮춘다.
- 역할 분리: temi 태블릿은 UI·이동·입출력만, Jetson은 두뇌·GPIO 제어를 담당한다.

## 2. 시스템 아키텍처

본 시스템은 4개 계층으로 구성된다.

① temi 안드로이드 태블릿 (커스텀 Kiosk 앱, Kotlin)

- 마이크 오디오 캡처, TTS 음성 출력
- temi SDK를 통한 로봇 이동/회전 제어
- 화면 UI (안내 문구, 얼굴 애니메이션)

② NVIDIA Jetson Orin Nano (로컬 두뇌 + 하드웨어 컨트롤러)

- 로컬 LLM(Gemma) 추론 서버 (llama.cpp)
- REST API 서버 (FastAPI) — temi 앱의 요청 처리
- 클라우드 API 프록시 (OpenAI / Gemini 키 보관)
- GPIO를 통한 서류함 박스 서보모터 제어

③ 클라우드 API

- OpenAI Whisper (STT) 및 OpenAI TTS
- Google Gemini (복잡 의도 파악 + function calling)

④ 직원/부서 데이터베이스

- Firestore 또는 Supabase (기존 클럽 프로젝트에서 검토했던 후보)
- 스키마: 이름 – 부서 – 위치명(temi 저장 위치와 매핑) – 연락처 – 알림 채널

### 2.1 네트워크 구성

- temi 태블릿과 Jetson은 물리적으로 별개의 컴퓨터이므로 동일 WiFi 또는 USB-이더넷 직결로 연결한다.
- temi 앱은 Jetson의 로컬 IP(예: http://192.168.x.x:8000)로 HTTP 요청을 보낸다.
- 학교 네트워크 불안정에 대비해 타임아웃·재시도 로직을 필수 적용한다.

## 3. 하드웨어 구성

### 3.1 Jetson Orin Nano 통합

- 모델: Jetson Orin Nano Developer Kit 8GB
- OS/드라이버: NVIDIA JetPack 6 SDK 필수 (CUDA, cuDNN, TensorRT 포함). 일반 Ubuntu 이미지로는 GPU 가속 불가.
- 저장장치: LLM 모델 파일이 크므로 SD카드 대신 SSD 강력 권장.

### 3.2 전원

- temi 내부 배터리에서 전원을 분기할 경우 Jetson 요구 전압으로 강압(step-down) 컨버터 필요.
- 서보모터 전원은 Jetson GPIO 핀에서 직접 끌지 않고 별도 5V 전원으로 공급 (핀 손상 방지).

### 3.3 무게 및 프레임

- temi는 본래 태블릿 1개만 얹는 설계이므로 Jetson + 서류함 박스 추가 시 무게중심 변화 발생.
- 회전 반경·주행 안정성에 영향을 줄 수 있으므로 프레임 보강 및 무게 분산 설계를 사전 진행한다.

## 4. 소프트웨어 구성 요소별 상세

### 4.1 음성인식 (STT) — OpenAI Whisper 교체

문제: temi 네이티브 STT는 wakeup()으로 시작해 AsrListener로 결과를 받는 구조이며, "Hey temi" 웨이크워드 없이 프로그래밍적으로 STT를 트리거하는 공식 방법이 막혀 있다.

해결:

1. robot.wakeup() 대신 Android AudioRecord로 마이크를 직접 캡처
2. 자체 VAD(음성 구간 감지)로 발화 시작/끝 판단
3. 잘라낸 오디오를 Jetson 서버로 전송 → OpenAI Whisper(whisper-1 또는 gpt-4o-transcribe)로 전사

주의: 직접 캡처 시 temi의 4-마이크 빔포밍/노이즈 처리 이점을 못 받을 수 있으므로, 실제 로비 소음 환경에서 인식률 테스트 필요.

### 4.2 의도 파악 + 라우팅 — Gemma(로컬) + Gemini(클라우드) 하이브리드

1. 전사된 텍스트 + 직원 DB를 컨텍스트로 LLM에 전달
2. Function calling으로 구조화된 출력 획득:
  - find_person(name) → DB 조회 → {location, contact}
  - navigate_intent(destination) → temi 저장 위치명으로 매핑
3. 라우팅 규칙:
  - 단순 질의(시간, 화장실 위치 등) → 로컬 Gemma가 즉시 응답
  - 복잡 의도(특정 담당자 탐색, 애매한 요청 해석) → 클라우드 Gemini로 위임

### 4.3 음성 합성 (TTS) — OpenAI TTS 교체

- AndroidManifest.xml에 com.robotemi.sdk.metadata.OVERRIDE_TTS 메타데이터를 선언하면 커스텀 TTS 엔진(ITtsService 구현)으로 교체 가능.
- 여기에 OpenAI TTS 또는 Google Cloud TTS를 연결해 목소리를 자연스럽게 변경.

### 4.4 이동 제어 — temi SDK

- Gemini/Gemma가 반환한 위치명을 temi SDK의 goTo() 계열 API로 실행.
- 속도는 speedLevel 파라미터로 0.1~1.5 m/s 범위 조절 가능.
- backwards(후진), noRotationAtEnd(도착 시 회전 생략), highAccuracyArrival(정밀 도착) 등 세부 옵션 활용.

### 4.5 담당자 알림

- 방문 의도 파악 후 Jetson 백엔드에서 담당자에게 웹훅으로 알림 발송.
- 채널: 슬랙 / 카카오워크 / 문자(SMS) 중 택.
- 예시 메시지: "OO님이 방문하여 302호로 이동 중입니다."

## 5. 로컬 LLM (Jetson Gemma) 상세

- 권장 모델: Gemma 4 E2B (Orin Nano 8GB에 가장 적합)
- 실행 경로: llama.cpp (정공법). Ollama는 현재 Orin Nano에서 Gemma 4 미지원.
- 컨테이너: ghcr.io/nvidia-ai-iot/llama_cpp:latest-jetson-orin
- 성능 참고: Gemma 3 4B는 CPU 17.5 tok/s, GPU 가속 시 Gemma 4 E2B는 약 25.5 tok/s. 단순 의도 파악은 실시간급 처리 가능.
- 멀티모달 확장: E2B/E4B는 오디오·텍스트·이미지 입력 지원 → 향후 카메라 기반 방문객 인식/상황 파악으로 확장 여지 있음.
- 메모리 주의: 8GB 공유 메모리 제약. swap 사용이 늘면 모델을 줄이거나 컨텍스트를 축소해야 함 (swap 증설은 해결책이 아님).

## 6. 서류함 박스 제어

### 6.1 구성

- 개폐: 서보모터
- (선택) 잠금: 솔레노이드 락
- 상태 감지: 리미트 스위치 또는 IR 센서 (박스 개폐 상태를 LLM이 참조 가능)

### 6.2 배선

- Orin Nano GPIO 핀은 3.3V만 출력 → 5V 서보 사용 시 레벨 시프터(예: TXS0108E) 필요.
- 서보 전력은 별도 5V 전원으로 공급 (Jetson 핀 직접 공급 금지).

### 6.3 제어 코드

- 단일 서보: Jetson.GPIO 라이브러리로 PWM(50Hz) 신호 생성, duty cycle로 각도 제어.
- 다중 서보: PCA9685 브레이크아웃 보드를 I2C로 연결하고 Adafruit ServoKit 사용 → 배선이 훨씬 깔끔.

## 7. 엔드투엔드 데이터 흐름 (예시 시나리오)

1. 방문객이 로봇 앞에서 말한다: "김민준 선생님 뵈러 왔어요."
2. temi 앱이 AudioRecord + VAD로 오디오 캡처 → Jetson 서버로 전송
3. Jetson이 OpenAI Whisper로 전사
4. 라우터가 "담당자 탐색" 복잡 의도로 판단 → Gemini 호출 (function calling)
5. Gemini가 find_person("김민준") 호출 → DB에서 {위치: 302호, 연락처} 반환
6. Jetson이 담당자에게 웹훅 알림 발송
7. temi 앱이 OpenAI TTS로 "302호로 안내해 드릴게요"를 음성 출력
8. temi SDK goTo("302호") 실행 → 자율 주행 안내

## 8. 개발 로드맵 (단계별)

Phase 0 — 준비

- temi SDK 개발 환경 구축, 개조 권한/보증 관련 확인
- Jetson Orin Nano 플래싱(JetPack 6), SSD 세팅

Phase 1 — 로컬 LLM 서버

- Jetson에 llama.cpp + Gemma 4 E2B 구동
- FastAPI로 추론 엔드포인트 노출, temi 앱과 통신 테스트

Phase 2 — 음성 파이프라인

- Android AudioRecord + VAD 구현
- Whisper STT, OpenAI TTS(OVERRIDE_TTS) 연동

Phase 3 — 의도 파악 + 라우팅

- 직원 DB 구축, function calling 스키마 설계
- Gemma/Gemini 하이브리드 라우터 구현

Phase 4 — 이동 + 알림

- goTo 연동, 위치명 매핑
- 담당자 웹훅 알림

Phase 5 — 서류함 박스

- 서보/센서 배선, 제어 코드
- 상태 연동

Phase 6 — 통합 테스트 및 튜닝

- 실제 소음 환경 인식률 테스트
- 지연시간 최적화 (필러 멘트: "잠시만요, 확인해 볼게요")

## 9. 부품 목록 (BOM)

분류 | 부품 | 비고
컴퓨팅 | NVIDIA Jetson Orin Nano Dev Kit 8GB | JetPack 6 필수
저장 | NVMe SSD | 모델 파일용, 강력 권장
전원 | Step-down 컨버터 | temi 배터리 분기 시
전원 | 별도 5V 전원 | 서보용
구동 | 서보모터 | 박스 개폐
구동 | (선택) 솔레노이드 락 | 박스 잠금
인터페이스 | 레벨 시프터 (TXS0108E 등) | 3.3V→5V
인터페이스 | (다중 서보 시) PCA9685 보드 | I2C
센서 | 리미트 스위치 / IR 센서 | 박스 상태 감지
네트워크 | USB-이더넷 어댑터 | 직결 옵션
기구 | 프레임 보강재, 박스 하우징 | 무게 분산

## 10. 위험 요소 및 대응

위험 | 영향 | 대응
API 키 노출 | 보안 사고 | 앱에 키 미포함, Jetson 서버 프록시 경유
네트워크 끊김 | 응대 중단 | 타임아웃·재시도, 단순 질의는 로컬 처리
인식률 저하 | 오동작 | 실제 소음 환경 테스트, VAD 튜닝
왕복 지연(2~4초) | UX 저하 | 하이브리드 라우팅, 필러 멘트
무게중심 변화 | 주행 불안정 | 프레임 보강, 무게 분산
GPIO 과전류 | 핀/보드 손상 | 레벨 시프터, 별도 전원
8GB 메모리 초과 | 추론 실패 | 모델·컨텍스트 축소 (swap 증설 금지)

## 11. 보안 고려사항

- 모든 클라우드 API 키는 Jetson 서버 환경변수로만 관리한다.
- temi 앱 ↔ Jetson 통신은 로컬 네트워크 내로 한정하고, 필요 시 토큰 인증을 추가한다.
- 방문객 개인정보(얼굴, 발화)는 최소 수집·즉시 폐기 원칙을 적용한다. 특히 카메라 인식 확장 시 개인정보 처리 방침을 별도 검토한다.

## 12. 확장 아이디어

- 카메라 기반 방문객 얼굴 인식으로 재방문자 맞춤 안내
- temi 텔레프레즌스 기능(createLinkBasedMeeting)과 결합해 원격 담당자 화상 연결
- 서류함에 무게 센서를 달아 문서 투입 여부 자동 확인
- 코드제로 클럽 교육용으로 goTo 위치 매핑·시퀀스 제작 실습 커리큘럼화

본 계획서는 초기 설계 문서이며, 각 Phase 진행 중 실제 하드웨어·SDK 동작 검증 결과에 따라 세부 사항이 조정될 수 있음.
