sion1223/temi-tranformation-v2/robotemi_official/README.md

# robotemi official repositories snapshot

Fetched from the public [robotemi GitHub organization](https://github.com/robotemi) on 2026-07-16.

| Folder | Source | Branch | Snapshot commit |
|---|---|---|---|
| `sdk` | https://github.com/robotemi/sdk.git | `master` | `0c50044` |
| `sample-app-media` | https://github.com/robotemi/sample-app-media.git | `main` | `5919dff` |
| `temi-Go` | https://github.com/robotemi/temi-Go.git | `main` | `c7a0cd8` |
| `Proxy-Launcher` | https://github.com/robotemi/Proxy-Launcher.git | `master` | `0559ebd` |
| `TemiGoProSDK` | https://github.com/robotemi/TemiGoProSDK.git | `main` | `896b2a6` |
| `sdk-wiki` | https://github.com/robotemi/sdk.wiki.git | `master` | `fb3de40` |

The nested `.git` directories were removed so the files can be tracked directly by this repository. To refresh the snapshot later, clone the sources again and record the new commit IDs here.
