sion1223/temi-tranformation-v2/robotemi_official/temi-Go/README.md

# Temi Go Build Status (https://app.bitrise.io/app/537e919b-afb0-4271-9822-b7bfc68df267) 



## About The Project

Temi Go can be used to deliver items.

## How to use

Select a tray layer then assign a destination. Press go to start moving. Will switch back to idle screen after arrival.

Each destination can be assigned to more than one tray. Press the cross button to unassign.

## Built with

- Kotlin

- Jetpack Compose

- Temi SDK

Based on Google Android Architecture multi-module templates.

https://github.com/android/architecture-templates/tree/multimodule

## Recommendation

- Arrival screen

- Proceed to the next destination after arrival

- Pause screen for restart, positioning etc

- Error handling
