sion1223/temi-tranformation-v2/robotemi_official/sdk-wiki/_Sidebar.md

#### General

- [Home](https://github.com/robotemi/sdk/wiki)
- [Release Info](https://github.com/robotemi/sdk/wiki/Release-Info)
- [Install/Uninstall On Temi](https://github.com/robotemi/sdk/wiki/Installing-and-Uninstalling-temi-Applications)
- [Robot API](https://github.com/robotemi/sdk/blob/master/docs/sdk/com.robotemi.sdk/-robot/index.md)

[//]: <> (- [Developer FAQs] TBD)
[//]: <> (- [JavaDoc] TBD)

#### Features

- [Follow](https://github.com/robotemi/sdk/wiki/Follow)
- [Navigation & Map](https://github.com/robotemi/sdk/wiki/Locations)
  - [Local Map Backup](https://github.com/robotemi/sdk/wiki/LocalMap)
- [Movement](https://github.com/robotemi/sdk/wiki/Movement)
- [Speech](https://github.com/robotemi/sdk/wiki/Speech)
- [Users & Telepresence](https://github.com/robotemi/sdk/wiki/Users-&-Telepresence)
- [System](https://github.com/robotemi/sdk/wiki/Utils)

##### Advanced Features

- [Kiosk Mode](https://github.com/robotemi/sdk/wiki/Kiosk-Mode)
- [Detection & Interaction](https://github.com/robotemi/sdk/wiki/Detection-&-Interaction)
- [Permission](https://github.com/robotemi/sdk/wiki/permission)
- [Face Recognition & Sequence](https://github.com/robotemi/sdk/wiki/temi-Center)
  - [Local Face Registration](https://github.com/robotemi/sdk/wiki/LocalFace)
- [Activity Stream](https://github.com/robotemi/sdk/wiki/activity_stream)

[//]: <> (- [Activity Stream] TBD)

##### temi GO

- [Serial Communication](https://github.com/robotemi/sdk/wiki/Serial-Communication)

### 中文版

#### 概要

- [主页](https://github.com/robotemi/sdk/wiki/Home_chn)
- [版本发布信息](https://github.com/robotemi/sdk/wiki/Release-Info_chn)
- [安装、卸载应用](https://github.com/robotemi/sdk/wiki/Installing-and-Uninstalling-temi-Applications_chn)
- [接口](https://github.com/robotemi/sdk/blob/master/docs/sdk/com.robotemi.sdk/-robot/index.md)

[//]: <> (- [开发者常见问题解答] 待定)
[//]: <> (- [Java文档] 待定)

#### 功能

- [跟随](https://github.com/robotemi/sdk/wiki/Follow_chn)
- [导航与地图](https://github.com/robotemi/sdk/wiki/Locations_chn)
  - [本地地图备份](https://github.com/robotemi/sdk/wiki/LocalMap_chn)
- [移动](https://github.com/robotemi/sdk/wiki/Movement_chn)
- [语音](https://github.com/robotemi/sdk/wiki/Speech_chn)
- [用户与视频通话](https://github.com/robotemi/sdk/wiki/Users-&-Telepresence_chn)
- [系统](https://github.com/robotemi/sdk/wiki/Utils_chn)

#### 高级功能

- [商店（Kiosk）模式](https://github.com/robotemi/sdk/wiki/Kiosk-Mode_chn)
- [用户检测与用户交互](https://github.com/robotemi/sdk/wiki/Detection-&-Interaction_chn)
- [权限](https://github.com/robotemi/sdk/wiki/permission_chn)
- [人脸识别 & 导览](https://github.com/robotemi/sdk/wiki/temi-Center_chn)
  - [本地人脸注册](https://github.com/robotemi/sdk/wiki/LocalFace_chn)

[//]: <> (- [活动] 待定)

#### temi GO 送餐送货机器人

- [串口通讯](https://github.com/robotemi/sdk/wiki/Serial-Communication_chn)
