sion1223/temi-tranformation-v2/basket/smart_lock_box_r3/drawings/01_single_tray_open.png

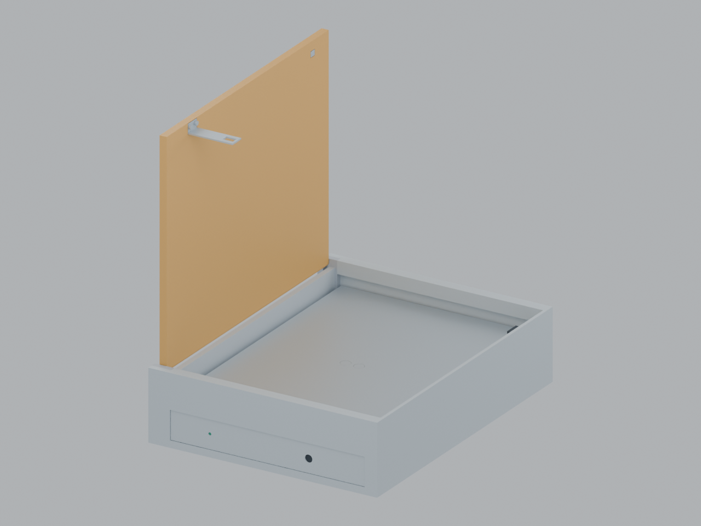
basket/smart_lock_box_r3/drawings/01_single_tray_open.png
