sion1223/temi-tranformation-v2/basket/smart_lock_box_r3/drawings/02_a4_fit.png

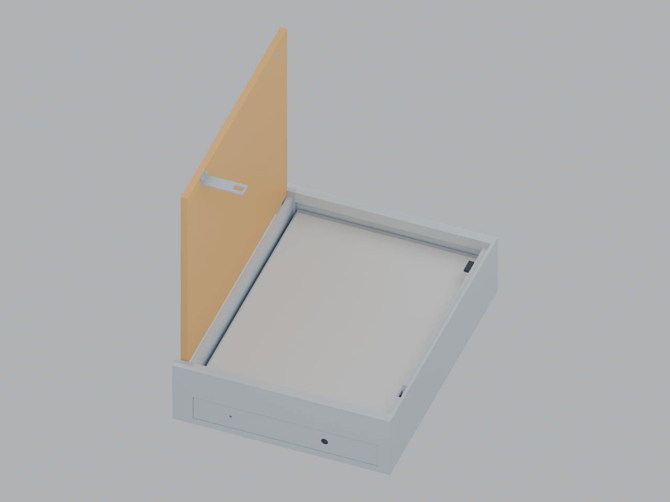
basket/smart_lock_box_r3/drawings/02_a4_fit.png
