sion1223/temi-tranformation-v2/basket/smart_lock_box_r3/drawings/03_lower_electronics.png

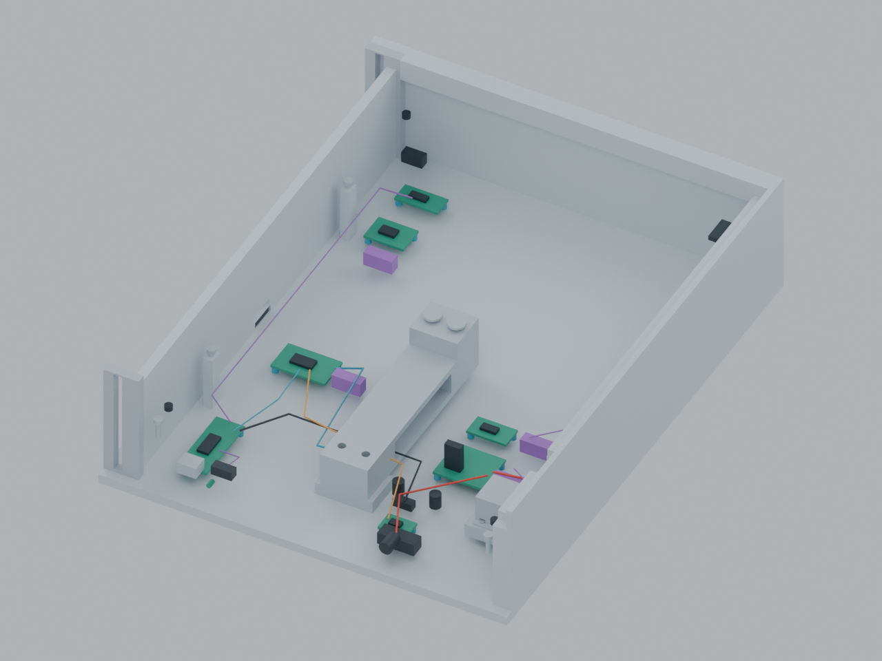
basket/smart_lock_box_r3/drawings/03_lower_electronics.png
