sion1223/temi-tranformation-v2/basket/smart_lock_box_r3/drawings/04_single_point_load_path.png

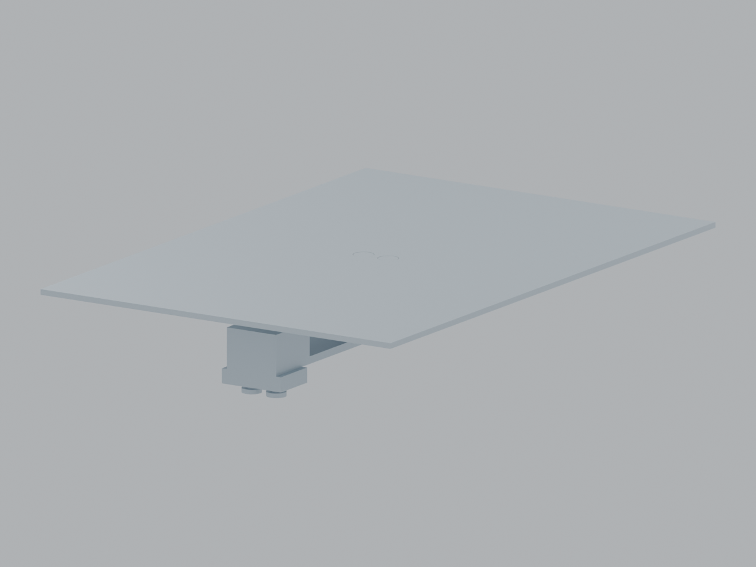
basket/smart_lock_box_r3/drawings/04_single_point_load_path.png
