sion1223/temi-tranformation-v2/basket/smart_lock_box_r3/drawings/05_underfloor_latch.png

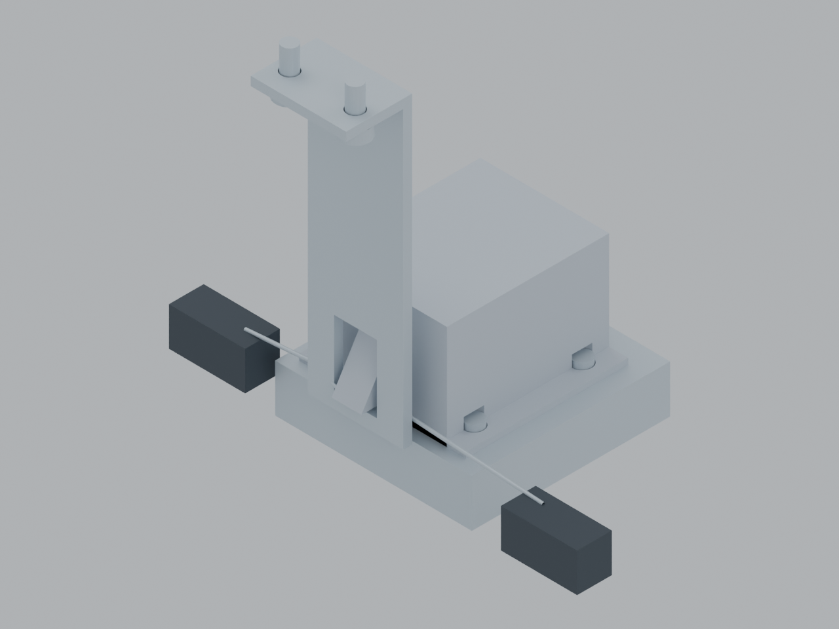
basket/smart_lock_box_r3/drawings/05_underfloor_latch.png
