sion1223/temi-tranformation-v2/basket/smart_lock_box_r3/drawings/06_stowed_elevation.png

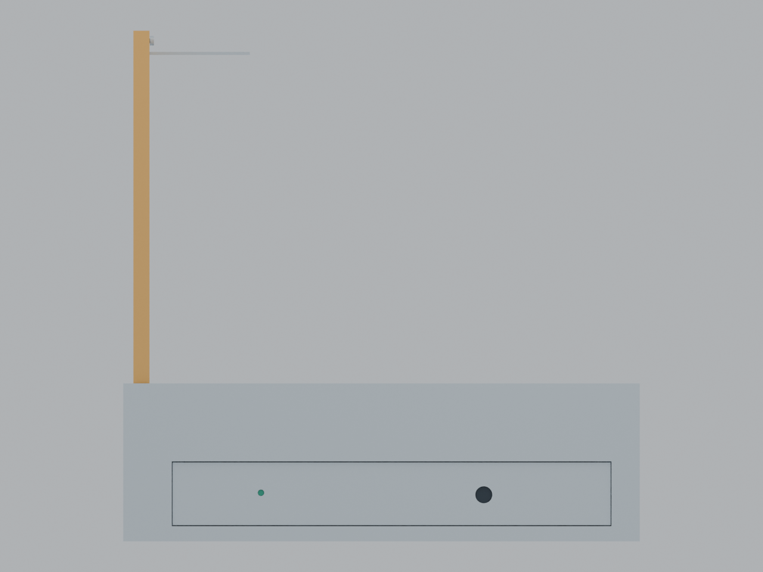
basket/smart_lock_box_r3/drawings/06_stowed_elevation.png
