sion1223/temi-tranformation-v2/basket/smart_lock_box_r3/drawings/07_double_floor_exploded.png

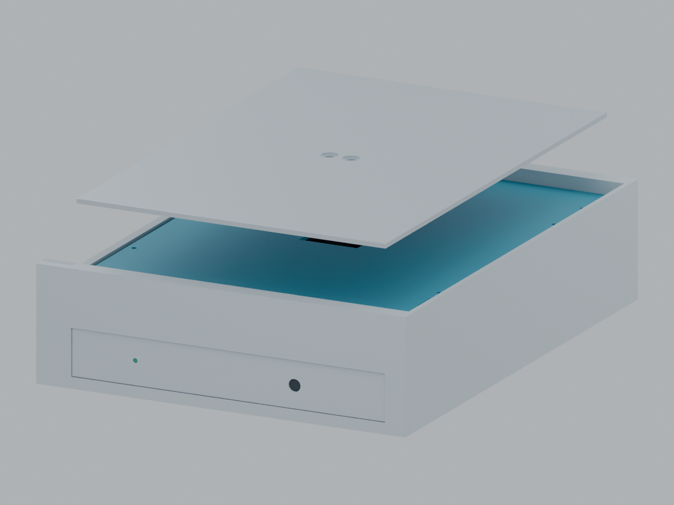
basket/smart_lock_box_r3/drawings/07_double_floor_exploded.png
