sion1223/temi-tranformation-v2/basket/smart_lock_box_r3_lift/drawings/02_closed.png

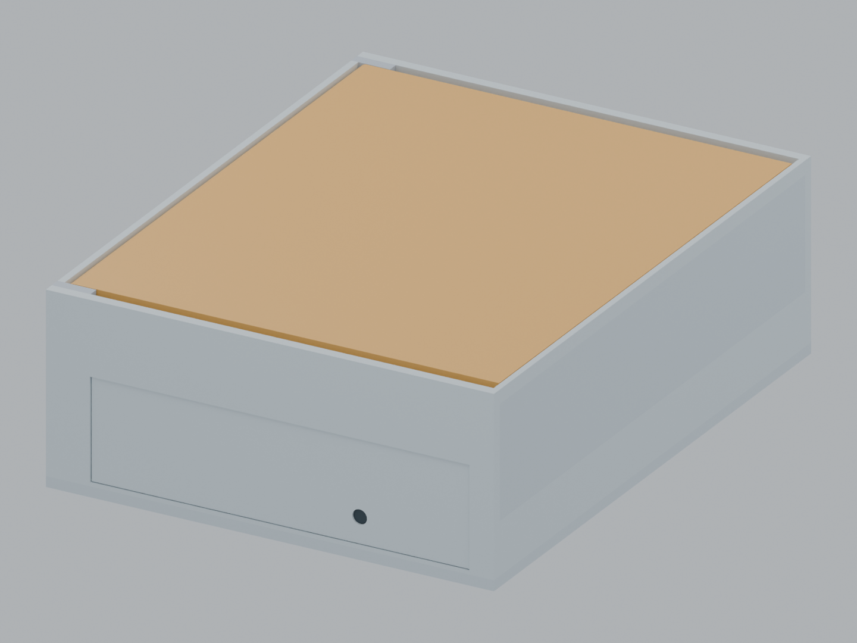
basket/smart_lock_box_r3_lift/drawings/02_closed.png
