sion1223/temi-tranformation-v2/basket/smart_lock_box_r3_lift/drawings/03_internal_drive.png

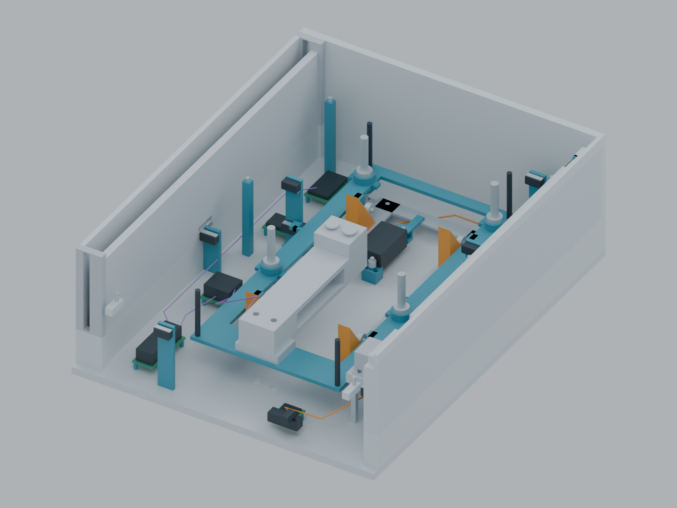
basket/smart_lock_box_r3_lift/drawings/03_internal_drive.png
