sion1223/temi-tranformation-v2/basket/smart_lock_box_r3_lift/drawings/04_mechanism_down.png

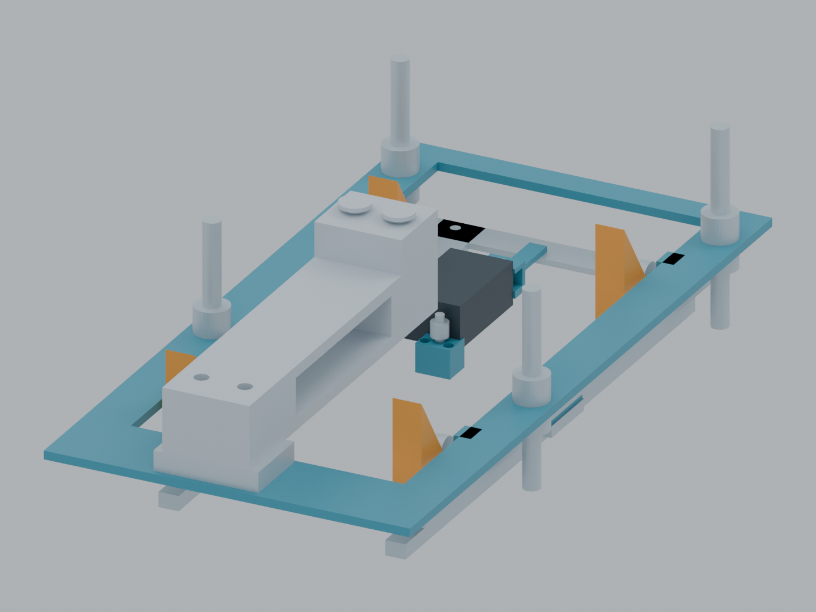
basket/smart_lock_box_r3_lift/drawings/04_mechanism_down.png
