sion1223/temi-tranformation-v2/basket/smart_lock_box_r3_lift/drawings/06_front_elevation.png

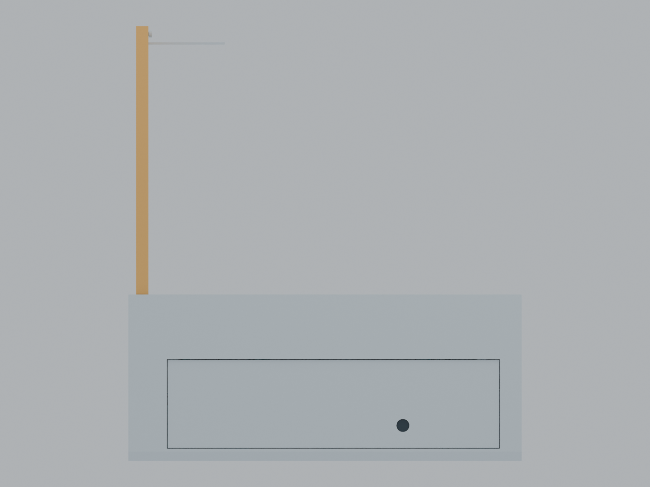
basket/smart_lock_box_r3_lift/drawings/06_front_elevation.png
