sion1223/temi-tranformation-v2/basket/smart_lock_box_r3_lift/PURCHASE_LIST.md

# R3-LIFT 주문 부품표

확인일: 2026-09-09. 구매를 실행하지 않았다. USD 가격은 페이지 표시값이며 배송·관세·환율·가공비를 포함하지 않는다. 정확한 옵션을 먼저 맞춘다.

|Ref|구매 부품|수량|주문 옵션|확인 가격|
|---|---|---:|---|---|
|M1|[Actuonix PQ12-100-12-S](https://www.actuonix.com/pq12-100-12-s)|1|100:1 / 12V / S형 / 20mm. R형 6V나 P형으로 임의 대체 금지|$65|
|M1-C|[Actuonix PQ12 Cable Adapter with S Extension Cable](https://www.actuonix.com/cable-adapter-s-bundle)|1|PQ12 S 전용 케이블 어댑터 포함 묶음|$6|
|U-M|[Pololu DRV8876 carrier #4036](https://www.pololu.com/product/4036)|1|15.2×17.8mm / 12V 양방향 구동. 출고 2A 제한을 그대로 사용하지 않음|$8.15|
|GR1..2|[RobotDigg 440C MGN7 rail + MGN7C carriage](https://www.robotdigg.com/product/840/440C-SUS-MGN7-linear-rail-with-carriage)|2|SS_MGN7-200L / 200mm / 표준 MGN7C 블록 1개씩. MGN7H 제외|확인 필요|
|BR1..4|[623ZZ miniature ball bearing](https://us.misumi-ec.com/blog/ball-bearings/miniature/623-ball-bearings-3x10x4mm-z-zz-2rs/)|4|내경3 / 외경10 / 폭4mm / ZZ 양면 실드. V623·F623 대체 금지|확인 필요|
|GB1..4|[RobotDigg LM6UU linear bearing](https://www.robotdigg.com/product/42)|4|내경6 / 외경12 / 길이19mm. LM6LUU 35mm 제외|확인 필요|
|GS1|[Hardened 6mm smooth rod](https://www.robotdigg.com/product/1047/6mm-smooth-rods-267mm%2C-300mm%2C-400mm-and-500mm)|1|Ø6×300mm 1개 구입 → 68mm 4개 절단·양끝 면취. 절단 손실 포함|확인 필요|
|LC1|[Zemic L6D-C3-3kg-0.40B](https://www.dscbalances.com/products/zemic-l6d-aluminium-single-point-load-cell-oiml-approved-3kg-50kg)|1|반드시 C3 / 3kg / 0.40B. 판매 페이지에 용량 옵션이 없으면 정확한 형번 확인 후 주문|$30|
|U-HX|[Adafruit HX711 #5974](https://www.adafruit.com/product/5974)|1|25.5×23×12.1mm / 10SPS / A채널 gain128 / VCC와 VIO 모두 5V|$9.95|
|U1|[Arduino Nano A000005](https://store.arduino.cc/products/arduino-nano)|1|ATmega328P 5V / 18×45mm. 아래쪽 핀 높이 포함 배치 여유 확인|확인 필요|
|U-BLE|[Adafruit Bluefruit LE UART Friend #2479](https://www.adafruit.com/products/2479)|1|21×32×5mm / UART / 5V 입력 허용 / CTS·RTS 배선|$17.5|
|U-IO|[Adafruit MCP23017 breakout #5346](https://www.adafruit.com/product/5346)|1|43×18×5mm / 5V / I2C 주소0x20 / 센서 입력 확장|$5.95|
|U5|[Pololu D24V10F5 #2831](https://www.pololu.com/product/2831)|1|5V 1A / 17.78×12.7×3.56mm / 12V 입력|$12.95|
|L1|[Adafruit lock solenoid #5065](https://www.adafruit.com/product/5065)|1|12V / 약350mA / R3 잠금 형상 유지|$7.5|
|S1..10|[D2F-01L SPDT lever microswitch](https://www.digikey.com/en/products/detail/omron-electronics-inc-emc-div/D2F-01L/83264)|10|PC pin / 12.8×5.8×6.5mm 본체 / 좌우 상·하 4 + 래치2 + 덮개2 + 패널·보호판2|$1.44|
|Q1|[IRLZ44NPBF](https://www.aliexpress.com/w/wholesale-IRLZ44NPBF.html)|1|TO-220 / logic-level N-MOSFET / 5V gate|확인 필요|
|D1|[1N4007](https://www.aliexpress.com/w/wholesale-1N4007-diode.html)|1|DO-41 / 솔레노이드 코일 플라이백 전용|확인 필요|
|D0|[SB310](https://www.aliexpress.com/w/wholesale-SB310-diode.html)|1|3A 100V Schottky / 입력 역극성 보호|확인 필요|
|F1|[T1A 250V 5x20 fuse + holder](https://www.aliexpress.com/w/wholesale-T1A-fuse-5x20-holder.html)|1|메인 12V 가지 / DC 차단 정격 확인|확인 필요|
|F2|[T315mA 250V 5x20 fuse + holder](https://www.aliexpress.com/w/wholesale-T315mA-fuse-5x20-holder.html)|1|모터 가지 / DC 차단 정격·기동 내량 실측|확인 필요|
|R-set|[금속피막 1% 0.25W 저항](https://www.aliexpress.com/w/wholesale-metal-film-resistor-1-percent-kit.html)|1|220Ω×1;47kΩ×1;10kΩ×4;100kΩ×1;33kΩ×1;1kΩ×3;866Ω×1 (DRV VREF 설정)|확인 필요|
|C-set|[전해·세라믹 커패시터](https://www.aliexpress.com/w/wholesale-capacitor-assortment-25V-470uF-100nF.html)|1|470uF25V×1;47uF10V×1;10uF10V×1;100nF50V×6|확인 필요|
|PCB|[2.54mm perfboard](https://www.aliexpress.com/w/wholesale-2.54mm-perfboard.html)|1|30×55mm 절단 / 하부 전원·잠금 회로|확인 필요|
|J1|[DC-022 5.5x2.1mm panel jack](https://www.aliexpress.com/w/wholesale-DC-022-5.5-2.1-panel-jack.html)|1|중앙+ / 12V 1A 이상 / 장착 외경8mm 확인|확인 필요|
|W1|[JST-XH 2.54 connectors and silicone wire](https://www.aliexpress.com/w/wholesale-JST-XH-2.54-connector-kit.html)|1|2P×3세트;4P×3세트;센서10개용3P×10세트;22AWG전원·28AWG신호|확인 필요|
|W2|[Shielded flexible load cell cable](https://www.aliexpress.com/w/wholesale-4-core-shielded-flexible-cable.html)|1|4심+실드 / 최소0.5m / 여유루프 및 고정클립|확인 필요|
|PS1|[12V 2A regulated external adapter](https://www.aliexpress.com/w/wholesale-12V-2A-power-supply-5.5-2.1.html)|1|KC인증 제품 / 5.5×2.1mm 중앙+ / 220V AC 입력. 상자 내부 배터리 아님|확인 필요|
|H1|[M2 fasteners](https://www.aliexpress.com/w/wholesale-M2-metric-screw-assortment.html)|1|레일용M2×6 28개;캐리지용M2×6 8개(실효나사물림2.5mm);스위치용M2×12 20개+너트|확인 필요|
|H2|[M3 fasteners](https://www.aliexpress.com/w/wholesale-M3-metric-screw-assortment.html)|1|PQ12 부속 우선;램프M3×8 8개;보호판M3×10 4개;패널M3×14 2개;샤프트클램프M3×16 8개;조절·예비M3 12개|확인 필요|
|H3|[3mm shoulder bolts and washers](https://www.aliexpress.com/w/wholesale-3mm-shoulder-screw-16mm.html)|4|롤러 축 Ø3 매끈한 어깨 / 유효어깨16mm / 623 내륜만 체결 / 외륜 비접촉|확인 필요|
|H4|[M6 load cell fasteners](https://www.aliexpress.com/w/wholesale-M6-low-head-socket-screw.html)|4|고정단2·가동단2 / R3 구멍피치 / 물림·카운터보어는 납품 도면 대조|확인 필요|
|H5|[M2.5 keeper screws](https://www.aliexpress.com/w/wholesale-M2.5-socket-screw.html)|2|R3 블라인드 체결 / 바깥면 관통 금지|확인 필요|

**조달 구분:** M1~S1..10은 실제 판매/제조사 페이지를 확인했다. 표준 소모품은 규격을 지정한 AliExpress 검색 링크이며, 특정 판매 물건을 검증했다는 뜻이 아니다. 특히 LC1은 L6D 판매 페이지는 있으나 3kg 옵션을 구매 전에 확인해야 한다. MGN7·LM6UU·623ZZ는 AliExpress에서도 동일 규격을 검색할 수 있지만, 치수·재질이 다른 대체품을 그대로 쓰면 안 된다.

**별도 가공품:** 케이스·적재판·프레임·램프·브래킷·가드는 아래 `FABRICATION.md`와 `parts/`를 따른다. 이들은 완제품 구매 부품이 아니다. 3D 프린트 출력만으로 금속 프레임과 축을 대체하지 않는다.

[가공 및 조립](FABRICATION.md) · [회로·동작 조건](CONTROL_AND_WIRING.md) · [전체 CSV](BOM.csv)
