sion1223/temi-tranformation-v2/(list of files, cad)

Other CAD files:
Head_2.0.33/Head_α2.0.33/Printing and Assembly/Reference Assembly (Open with Microsoft 3D Viewer or Blender).obj
.sites-design-options/head-web-groups.obj
basket/smart_lock_box_r3/fabrication/R3_cell_fixed_pedestal.stl
basket/smart_lock_box_r3/STL_print/R3_overload_stop.001.stl
basket/smart_lock_box_r3_lift/parts/L_HX711_standoff.001.stl
basket/smart_lock_box_r3/STL_print/R3_Arduino_Nano_spacer.001.stl
basket/smart_lock_box_r3_lift/parts/L_overload_stop_80_284.stl
Head_2.0.33/Head_α2.0.33/Printing and Assembly/AllComponents.stl
basket/smart_lock_box_r3/STL_print/셸_격납슬롯내벽.stl
basket/smart_lock_box_r3_lift/parts/L_switch_mount_deck.stl
Head_2.0.33/Head_α2.0.33/Printing and Assembly/BambuPrintfile.3mf
basket/smart_lock_box_r3/STL_print/R3_rear_top_seal.stl
basket/smart_lock_box_r3_lift/parts/L_bushing_tab_194_140_-10.stl
basket/smart_lock_box_r3/STL_print/R3_Arduino_Nano_spacer.stl
basket/smart_lock_box_r3_lift/parts/R3_lock_base.stl
basket/smart_lock_box_r3/STL_print/R3_MOSFET_driver_spacer.001.stl
basket/smart_lock_box_r3_lift/parts/L_Nano_standoff.001.stl
basket/smart_lock_box_r3/fabrication/R3_fixed_electronics_deck.stl
basket/smart_lock_box_r3/STL_print/R3_front_top_seal.stl
basket/smart_lock_box_r3_lift/parts/L_MCP23017_standoff.001.stl
basket/smart_lock_box_r3/STL_print/R3_front_wall.stl
basket/smart_lock_box_r3_lift/parts/L_bearing_holder_84_140.stl
basket/smart_lock_box_r3/STL_print/R3_deck_support.002.stl
basket/smart_lock_box_r3_lift/parts/L_roller_bracket_100_250.stl
basket/smart_lock_box_r3/STL_print/R3_deck_support.001.stl
basket/smart_lock_box_r3_lift/parts/L_switch_mount_latch_extended.stl
basket/smart_lock_box_r3/STL_print/R3_BLE_3V3_spacer.001.stl
basket/smart_lock_box_r3_lift/parts/L_cradle_rear.stl
basket/smart_lock_box_r3/STL_print/R3_MOSFET_driver_spacer.stl
basket/smart_lock_box_r3_lift/parts/L_bushing_tab_84_140_-10.stl
basket/smart_lock_box_r3/STL_print/R3_LDO_level_shift_spacer.stl
basket/smart_lock_box_r3_lift/parts/L_D24V10F5_standoff.stl
basket/smart_lock_box_r3/STL_print/R3_D24V10F5_spacer.stl
basket/smart_lock_box_r3_lift/parts/L_bearing_holder_194_140.stl
basket/smart_lock_box_r3/STL_print/R3_deck_support.003.stl
basket/smart_lock_box_r3_lift/parts/L_panel_internal_ear_229.stl
basket/smart_lock_box_r3/STL_print/R3_right_top_seal.stl
basket/smart_lock_box_r3_lift/parts/R3_right_wall.stl
basket/smart_lock_box_r3/STL_print/R3_right_wall.stl
basket/smart_lock_box_r3_lift/parts/L_flag_bridge_58.stl
basket/smart_lock_box_r3/STL_print/R3_HX711_5V_carrier_spacer.001.stl
basket/smart_lock_box_r3_lift/parts/L_bushing_tab_194_270_-10.stl
basket/smart_lock_box_r3/STL_print/R3_BLE_3V3_spacer.stl
basket/smart_lock_box_r3_lift/parts/L_slide_spacer_100.stl
basket/smart_lock_box_r3/STL_print/R3_power_sense_100k33k_spacer.001.stl
basket/smart_lock_box_r3_lift/parts/L_lock_pedestal_233_48.stl
basket/smart_lock_box_r3/STL_print/R3_power_sense_100k33k_spacer.stl
basket/smart_lock_box_r3_lift/parts/L_slide_spacer_178.stl
basket/smart_lock_box_r3/STL_print/R3_HX711_5V_carrier_spacer.stl
basket/smart_lock_box_r3_lift/parts/L_deck_post_224_300.stl
basket/smart_lock_box_r3/STL_print/R3_LDO_level_shift_spacer.001.stl
basket/smart_lock_box_r3_lift/parts/L_BLE_standoff.stl
basket/smart_lock_box_r3/STL_print/R3_overload_stop.002.stl
basket/smart_lock_box_r3_lift/parts/L_slider_crossbar.stl
basket/smart_lock_box_r3/STL_print/R3_rear_wall.stl
basket/smart_lock_box_r3_lift/parts/L_DRV8876_standoff.001.stl
basket/smart_lock_box_r3/STL_print/R3_overload_stop.stl
basket/smart_lock_box_r3_lift/parts/L_PQ12_link_clevis.stl
basket/smart_lock_box_r3/STL_print/R3_D24V10F5_spacer.001.stl
basket/smart_lock_box_r3_lift/parts/L_power_and_latch_board_standoff.stl
basket/smart_lock_box_r3/STL_print/R3_captive_front_panel.stl
basket/smart_lock_box_r3_lift/parts/L_limit_flag_210.stl
basket/smart_lock_box_r3/STL_print/R3_overload_stop.003.stl
basket/smart_lock_box_r3_lift/parts/L_flag_bridge_210.stl
basket/smart_lock_box_r3/STL_print/R3_deck_support.stl
basket/smart_lock_box_r3_lift/parts/L_captive_service_panel.stl
basket/smart_lock_box_r3_lift/parts/L_shaft_socket_194_270.stl
basket/smart_lock_box_r3_lift/parts/L_moving_skirt_left.stl
basket/smart_lock_box_r3_lift/parts/L_MCP23017_standoff.stl
basket/smart_lock_box_r3_lift/parts/L_switch_mount_closed.stl
basket/smart_lock_box_r3_lift/parts/L_shaft_socket_194_140.stl
basket/smart_lock_box_r3_lift/parts/L_limit_switch_backplate_58.stl
basket/smart_lock_box_r3_lift/parts/L_output_link.stl
basket/smart_lock_box_r3_lift/parts/도어_본체.stl
basket/smart_lock_box_r3_lift/parts/L_BLE_standoff.001.stl
basket/smart_lock_box_r3_lift/parts/L_right_top_seal.stl
basket/smart_lock_box_r3_lift/parts/도어_가이드판_앞.stl
basket/smart_lock_box_r3_lift/parts/L_deck_post_37_185.stl
basket/smart_lock_box_r3_lift/parts/L_deck_post_224_185.stl
basket/smart_lock_box_r3_lift/parts/L_guide_lower_support_6.stl
basket/smart_lock_box_r3_lift/parts/L_cell_fixed_pedestal.stl
basket/smart_lock_box_r3_lift/parts/R3_door_keeper.stl
basket/smart_lock_box_r3_lift/parts/L_lock_pedestal_210_72.stl
basket/smart_lock_box_r3_lift/parts/L_slot_inner_extension.stl
basket/smart_lock_box_r3_lift/parts/L_DRV8876_standoff.stl
basket/smart_lock_box_r3_lift/parts/L_PQ12_fixed_mount.stl
basket/smart_lock_box_r3_lift/parts/도어_가이드판_뒤.stl
basket/smart_lock_box_r3_lift/parts/L_panel_internal_ear_29.stl
basket/smart_lock_box_r3_lift/parts/L_slider_bar_178.stl
basket/smart_lock_box_r3_lift/parts/L_roller_bracket_178_250.stl
basket/smart_lock_box_r3_lift/parts/L_cradle_front.stl
basket/smart_lock_box_r3_lift/parts/L_bearing_holder_194_270.stl
basket/smart_lock_box_r3_lift/parts/L_overload_stop_198_284.stl
basket/smart_lock_box_r3_lift/parts/L_POM_ramp_100_250.stl
basket/smart_lock_box_r3_lift/parts/L_switch_mount_stowed.stl
basket/smart_lock_box_r3_lift/parts/L_cradle_side_76.stl
basket/smart_lock_box_r3_lift/parts/셸_격납슬롯내벽.stl
basket/smart_lock_box_r3_lift/parts/L_roller_bracket_178_110.stl
basket/smart_lock_box_r3_lift/parts/L_shaft_socket_84_140.stl
basket/smart_lock_box_r3_lift/parts/L_left_outer_wall.stl
basket/smart_lock_box_r3_lift/parts/L_switch_mount_latch_retracted.stl
basket/smart_lock_box_r3_lift/parts/L_limit_switch_foot_58.stl
basket/smart_lock_box_r3_lift/parts/L_panel_internal_ear_235.stl
basket/smart_lock_box_r3_lift/parts/L_overload_stop_80_44.stl
basket/smart_lock_box_r3_lift/parts/L_moving_skirt_front.stl
basket/smart_lock_box_r3_lift/parts/L_lock_pedestal_210_48.stl
basket/smart_lock_box_r3_lift/parts/L_switch_mount_panel.stl
basket/smart_lock_box_r3_lift/parts/R3_single_weighing_tray.stl
basket/smart_lock_box_r3_lift/parts/L_POM_ramp_178_250.stl
basket/smart_lock_box_r3_lift/parts/L_roller_bracket_100_110.stl
basket/smart_lock_box_r3_lift/parts/L_fixed_guard_deck.stl
basket/smart_lock_box_r3_lift/parts/L_limit_switch_foot_210.stl
basket/smart_lock_box_r3_lift/parts/L_deck_post_37_300.stl
basket/smart_lock_box_r3_lift/parts/L_limit_flag_58.stl
basket/smart_lock_box_r3_lift/parts/L_Nano_standoff.stl
basket/smart_lock_box_r3_lift/parts/L_shaft_socket_84_270.stl
basket/smart_lock_box_r3_lift/parts/L_D24V10F5_standoff.001.stl
basket/smart_lock_box_r3_lift/parts/L_right_lower_extension.stl
basket/smart_lock_box_r3_lift/parts/L_cradle_side_186.stl
basket/smart_lock_box_r3_lift/parts/L_moving_skirt_rear.stl
basket/smart_lock_box_r3_lift/parts/L_POM_ramp_100_110.stl
basket/smart_lock_box_r3_lift/parts/L_rear_wall.stl
basket/smart_lock_box_r3_lift/parts/L_guide_lower_support_312.stl
basket/smart_lock_box_r3_lift/parts/L_HX711_standoff.stl
basket/smart_lock_box_r3_lift/parts/L_front_wall.stl
basket/smart_lock_box_r3_lift/parts/R3_cell_loaded_spacer.stl
basket/smart_lock_box_r3_lift/parts/L_power_and_latch_board_standoff.001.stl
basket/smart_lock_box_r3_lift/parts/L_overload_stop_198_44.stl
basket/smart_lock_box_r3_lift/parts/L_POM_ramp_178_110.stl
basket/smart_lock_box_r3_lift/parts/L_slider_bar_100.stl
basket/smart_lock_box_r3_lift/parts/L_bearing_holder_84_270.stl
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
