sion1223/temi-tranformation-v2/basket/smart_lock_box_r3_lift/FABRICATION.md

# 가공·조립 기준 — R3-LIFT

좌표 X=폭, Y=앞→뒤, Z=아래→위, 단위mm. `placement.csv`는 **하강 상태의 조립 좌표**다. STL도 조립 좌표로 내보낸 형상 참고 파일이다. 실제 제작용 공차·나사 탭·용접 상세를 확정한 양산 도면은 아니다. 구매품은 STL로 제작하지 않는다.

|가공품|수량|재료·기준|
|---|---:|---|
|케이스·패널|1세트|외형255×324×108. 기존R3 도어·좌측가이드·잠금 형상을30mm 위로 이동. 케이스는 PETG/ASA 후보, 축/하중 지지는 금속으로 제작|
|A4 적재판|1|알루미늄213.5×308×3. R3 가동단 M6 두 곳 유지. 상면 나사 머리 돌출 제거|
|승강 프레임|1조립체|6061 알루미늄3t. 두 측면16×250, 앞쪽94×28, 뒤쪽94×10. 측면X76~92 /186~202, Z34~37. 코너는 TIG 용접 또는 별도 금속 연결판으로 구조화|
|셀 고정 스페이서|1|36×25×7, X112.75~148.75,Y42~67,Z37~44. M6 중심(123.25,54),(138.25,54)|
|기존 셀 가동 스페이서|1|R3 유지, Z66~78. 셀M6 구멍·케이블 출구는 구매 도면 대조|
|슬라이더 바|2|6061 17×198×2, 중심X100/178, Y82~280,Z16~18. 뒤 횡봉90×12×2와 견고하게 결합|
|슬라이더 스페이서|2|16×22×2, MGN7C와 바 사이. 체결4점은 X중심±6,Y180±4|
|POM-C 경사 램프|4|폭10, 길이25, 경사 arctan1.5=56.31°. 중심X100/178,Y110/250. 아래끝Z18. 높이는 CAD 기준. 수평18→수직27|
|롤러 브래킷·어깨축|4조|623ZZ의 내륜만 조이고 외륜은 자유회전. Ø3 어깨축16mm. 나사산을 롤링 접촉면으로 쓰지 않음|
|수직 가이드축|4|Ø6×68 경화연마축. 중심(84,140),(84,270),(194,140),(194,270), Z7~75|
|LM6UU 홀더·축 고정 소켓|각4|LM6UU Ø12×19. 하강 베어링Z27~46, 상승54~73. 분할 클램프/고정링을 추가 가공해 축방향 이탈 방지. STL 홀더는 외형 참고|
|모터 고정 브래킷·클레비스|각1|동봉 PQ12 브래킷을 우선 사용. 고정 핀(130,205,20), 로드 핀 하강(130,248,20)→상승(130,266,20). M3 핀으로 양쪽 관절 연결|
|고정 보호판·기둥|1+4|보호판202×292×3, Z71~74. 원점(30,16). 셀 통과구41×136과 가이드구·스토퍼구. 기둥중심(37/224,185/300)|
|움직이는 얇은 가드|4조각|0.8mm PC/PET 판. 적재판 밑에만 고정. 잠금·패널 회피 절개는 모델 참조. 바깥 고정벽과 비접촉 유지|
|과부하 스토퍼|4|중심(80/198,44/284), 정상 끝Z77.2, 적재판 아래와0.8mm 비접촉. 실측 처짐에 맞춰 나사식 높이 조정|
|스위치 지지대|8|양쪽 승강 상하 스위치 공용 백플레이트2개+나머지6개. 스위치 장착구멍Ø2/6.5mm피치를 실측 전사. UP스위치는 레버가 아래를 향하도록 뒤집어 장착|

**PQ12 주문치수와 사용치수:** 제조사 후면→로드 핀의 완전수축 공칭거리는42mm다. S형 내부 한계 스위치가 양끝 약1mm 안쪽에서 동작하므로 이 설계는43~61mm의18mm 사용 범위를 가정한다. 납품품의 실제 한계 위치를 측정하여 링크·스위치 위치를 조절한다. 유효스트로크가18mm에 못 미치면 상승량도 `1.5×실측 스트로크`로 줄며, 모터를 기계 스토퍼에 계속 밀어 넣어27mm를 강제하지 않는다. [PQ12 RevD](https://www.actuonix.com/assets/images/datasheets/ActuonixPQ12Datasheet.pdf)

**롤러 접촉 기준:** 반경5mm 롤러는 경사면의 법선 방향으로5mm 떨어져야 한다. 하강시 중심Z29, 롤러 중심Y에서 경사면Z=19.9861218. 접촉점Y는 중심보다4.1602515mm 앞쪽이다. 램프를+Y로18mm 움직이면 롤러 중심Z56이 된다. 단순히 경사면 위에 수직으로5mm를 더해서 배치하면 접촉 오류가 생긴다.

**조립 순서:** 바닥·하부 전장 → 수평레일·슬라이더·램프 → 모터와 관절링크 → 수직축·가이드·프레임·롤러 → 셀 고정단 → 보호판 → 셀 가동단·적재판·가드 → 기존R3 도어/잠금. 로드셀 고정단과 가동단 방향을 뒤집지 않는다. 평행한 레일과 수직축은 한쪽을 느슨하게 조립하고 전 구간을 이동시킨 뒤 정렬·조인다. 네 롤러 높이는 시임으로 맞춘다.

**기준면·최종 가공:** 램프 면 거칠기·평행도와 프레임 강성이 성능을 결정한다. MGN7 레일 구멍 피치는15mm지만 실제 절단 끝단 오프셋은 납품품으로 전사한다. 캐리지 나사 유효 물림은 공급자 표기2.5mm를 넘지 않도록 와셔/길이를 결정한다. 셀·스위치·브래킷에는 납품 도면에 맞춘 최종 구멍·고정 나사가 필요하다. 현재 STL의 예비 홀을 무조건 최종 치수로 간주하지 않는다.

배선·전자부품은 조립 형상과 공간 예약을 표현한다. 30×55mm 만능기판에 퓨즈/배선/절연을 실제로 설치하고, 모터 케이블과 로드셀 케이블을 분리한다. 가동 셀 케이블은 느슨한 서비스 루프와 고정단 스트레인 릴리프를 둔다. 렌더의 선은 배선 경로 설명이며 실제 굴곡 애니메이션이 아니다.

길이308~324mm 부품은220mm 프린터에 한 번에 들어가지 않는다. 큰 베드·CNC·판재 가공을 선택한다. 가이드/프레임/축을 플라스틱 출력물로 임의 대체할 때는 구조를 다시 검토해야 한다.
