sion1223/temi-tranformation-v2/robotemi_official/sdk/docs/sdk/com.robotemi.sdk.mediabar/-media-bar-data/-builder/current-track-position.md

//[sdk](../../../../index.md)/[com.robotemi.sdk.mediabar](../../index.md)/[MediaBarData](../index.md)/[Builder](index.md)/[currentTrackPosition](current-track-position.md)

# currentTrackPosition

[androidJvm]\
open fun [currentTrackPosition](current-track-position.md)(currentTrackPosition: [Int](https://kotlinlang.org/api/latest/jvm/stdlib/kotlin/-int/index.html)): [MediaBarData.Builder](index.md)

Call this method upon pause to resume from current position of track. Skill should store the current track position on pause

#### Return

## Parameters

androidJvm

| | |
|---|---|
| currentTrackPosition |  |
