sion1223/temi-tranformation-v2/robotemi_official/sdk/docs/sdk/com.robotemi.sdk.notification/-normal-notification/-builder/primary-button.md

//[sdk](../../../../index.md)/[com.robotemi.sdk.notification](../../index.md)/[NormalNotification](../index.md)/[Builder](index.md)/[primaryButton](primary-button.md)

# primaryButton

[androidJvm]\
open fun [primaryButton](primary-button.md)(primaryButton: [String](https://docs.oracle.com/javase/8/docs/api/java/lang/String.html)): [NormalNotification.Builder](index.md)

open var [primaryButton](primary-button.md): [String](https://docs.oracle.com/javase/8/docs/api/java/lang/String.html)
