sion1223/temi-tranformation-v2/robotemi_official/sdk/docs/sdk/com.robotemi.sdk.notification/-normal-notification/-builder/secondary-button.md

//[sdk](../../../../index.md)/[com.robotemi.sdk.notification](../../index.md)/[NormalNotification](../index.md)/[Builder](index.md)/[secondaryButton](secondary-button.md)

# secondaryButton

[androidJvm]\
open fun [secondaryButton](secondary-button.md)(secondaryButton: [String](https://docs.oracle.com/javase/8/docs/api/java/lang/String.html)): [NormalNotification.Builder](index.md)

open var [secondaryButton](secondary-button.md): [String](https://docs.oracle.com/javase/8/docs/api/java/lang/String.html)
