sion1223/temi-tranformation-v2/basket/smart_lock_box_r3/hardware_measurements.csv

test | position | x_center_mm | y_center_mm | repeat | reference_mass_g | measured_g | stable_pp_g | detect_delay_s | removed_detected | result
A4_flat | 1 | 129.5 | 157 | 1 |  |  |  |  |  | NOT_RUN
A4_flat | 1 | 129.5 | 157 | 2 |  |  |  |  |  | NOT_RUN
A4_flat | 1 | 129.5 | 157 | 3 |  |  |  |  |  | NOT_RUN
A4_flat | 1 | 129.5 | 157 | 4 |  |  |  |  |  | NOT_RUN
A4_flat | 1 | 129.5 | 157 | 5 |  |  |  |  |  | NOT_RUN
A4_flat | 1 | 129.5 | 157 | 6 |  |  |  |  |  | NOT_RUN
A4_flat | 1 | 129.5 | 157 | 7 |  |  |  |  |  | NOT_RUN
A4_flat | 1 | 129.5 | 157 | 8 |  |  |  |  |  | NOT_RUN
A4_flat | 1 | 129.5 | 157 | 9 |  |  |  |  |  | NOT_RUN
A4_flat | 1 | 129.5 | 157 | 10 |  |  |  |  |  | NOT_RUN
A4_flat | 2 | 129.5 | 162 | 1 |  |  |  |  |  | NOT_RUN
A4_flat | 2 | 129.5 | 162 | 2 |  |  |  |  |  | NOT_RUN
A4_flat | 2 | 129.5 | 162 | 3 |  |  |  |  |  | NOT_RUN
A4_flat | 2 | 129.5 | 162 | 4 |  |  |  |  |  | NOT_RUN
A4_flat | 2 | 129.5 | 162 | 5 |  |  |  |  |  | NOT_RUN
A4_flat | 2 | 129.5 | 162 | 6 |  |  |  |  |  | NOT_RUN
A4_flat | 2 | 129.5 | 162 | 7 |  |  |  |  |  | NOT_RUN
A4_flat | 2 | 129.5 | 162 | 8 |  |  |  |  |  | NOT_RUN
A4_flat | 2 | 129.5 | 162 | 9 |  |  |  |  |  | NOT_RUN
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
