sion1223/temi-tranformation-v2/(list of files, drawings)

Other design files:
Head_2.0.33/Head_α2.0.33/Electronics (Open in EasyEDA)/ProDoc_Eyes_Brow_Neck_2025-04-16.epro
Head_2.0.33/Head_α2.0.33/Electronics (Open in EasyEDA)/ProDoc_Mouth Board_2025-04-16.epro
