sion1223/temi-tranformation-v2/Head_2.0.33/Head_α2.0.33/Code/Mouth.py

from machine import Pin
from time import sleep
from servo import Servo

led = Pin(25, Pin.OUT)
mode = Pin(28, Pin.IN, Pin.PULL_UP)

# --- ServoConfig Class ---
class SCFG:
    def __init__(self, pin_id, limits):
        self.servo = Servo(pin_id=pin_id)
        self.start, self.end = limits
        self.angle = self.start
        self.direction = 1  # Forward initially

    def move(self, angle):
        self.servo.write(angle)

    def step(self, step_size=1):
        # Calculate current step direction based on start vs end
        step = step_size if self.start < self.end else -step_size
        self.angle += self.direction * step

        # Reverse direction if past bounds
        if (self.direction == 1 and (
                (step > 0 and self.angle >= self.end) or (step < 0 and self.angle <= self.end))):
            self.angle = self.end
            self.direction = -1
        elif (self.direction == -1 and (
                (step > 0 and self.angle <= self.start) or (step < 0 and self.angle >= self.start))):
            self.angle = self.start
            self.direction = 1

        self.move(self.angle)

# --- Servo Setup ---
servos = {
    "JL": SCFG(4, (90,50)),
    "JR": SCFG(5, (90,130)),
    "LUL": SCFG(6, (80,100)),
    "LUR": SCFG(7, (80,100)),
    "LLL": SCFG(8, (10,170)),
    "LLR": SCFG(9, (80,100)),
    "CUL": SCFG(10, (80,100)),
    "CUR": SCFG(11, (80,100)),
    "CLL": SCFG(12, (80,100)),
    "CLR": SCFG(13, (80,100)),
    "TON": SCFG(14, (80,100)),
    "EXA": SCFG(15, (80,100)),
}

poses = {
    "mouth_closed": {
        "JL": 90, "JR": 90
    },
    "mouth_open": {
        "JL": 50, "JR": 130
    },
    "lips_down": {
        "LUL": 110, "LUR": 70, "LLL": 55, "LLR": 110
    },
    "lips_up": {
        "LUL": 40, "LUR": 140, "LLL": 110, "LLR": 60
    },
    "tongue_down": {
        "TON": 130
    },
    "tongue_up": {
        "TON": 55
    },
    "smile": {
        "CUL": 60, "CUR": 105, "CLL": 90, "CLR": 90
    },
    "frown": {
        "CUL": 100, "CUR": 75, "CLL": 90, "CLR": 90
    },    
    "wide": {
        "CUL": 65, "CUR": 105, "CLL": 120, "CLR": 65
    },
    "narrow": {
        "CUL": 90, "CUR": 80, "CLL": 90, "CLR": 90
    },
#     "Add more poses here as needed...": {
#         "JL": 110, "JR": 70, "LUL": 110, "LUR": 70, "LLL": 130, "LLR": 50,
#         "CUL": 80, "CUR": 80, "CLL": 100, "CLR": 80, "TON": 100, "EXA": 80
#     },
}

# --- Apply Pose Function ---
def apply_pose(pose_name):
    if pose_name in poses:
        for servo_name, angle in poses[pose_name].items():
            servos[servo_name].move(angle)
    else:
        print(f"Pose {pose_name} not found!")

p = 0.5

# --- Main Loop ---
while True:
    led.value(not led.value())  # blink onboard LED
#     print(mode.value())
    if (mode.value() == 1):
        for s in servos.values():
#             apply_pose("wide")
#             sleep(p)
#             apply_pose("narrow")
#             sleep(p)
#             apply_pose("smile")
#             sleep(p)
#             apply_pose("frown")
#             sleep(p)
#             apply_pose("tongue_down")
#             sleep(p)
#             s.step()
#             apply_pose("mouth_closed")
#             sleep(p)
#             apply_pose("mouth_open")
#             sleep(p)
#             apply_pose("mouth_closed")
#             sleep(p)
#             apply_pose("lips_down")
#             sleep(p)
#             apply_pose("lips_up")
#             sleep(p)
#             apply_pose("lips_down")
#             sleep(p)
    if (mode.value() == 0):
        for s in servos.values():
            s.move(90)
    sleep(0.01)
 
