sion1223/temi-tranformation-v2/temi-classroom-delivery/arduino-basket-controller/arduino_secrets.example.h

#pragma once

// Copy this file to arduino_secrets.h and fill in device-local values.
// arduino_secrets.h is intentionally excluded from Git.
#define TEMI_WIFI_SSID "REPLACE_WITH_CLASSROOM_WIFI"
#define TEMI_WIFI_PASSWORD "REPLACE_WITH_WIFI_PASSWORD"
#define TEMI_DEVICE_ID "basket-01"
#define TEMI_DEVICE_TOKEN "REPLACE_WITH_PER_DEVICE_BEARER_TOKEN"
