sion1223/temi-tranformation-v2/(commit log)

2026-07-15 Add Head 2.0.33 assets
    [AllComponents.stl, BambuPrintfile.3mf, ProDoc_Eyes_Brow_Neck_2025-04-16.epro, ProDoc_Mouth Board_2025-04-16.epro, Reference Assembly (Open with Microsoft 3D Viewer or Blender).obj]
2026-09-03 feat(temi): add classroom delivery MVP
    Implement kiosk startup, configurable voice input, Luna-first AI with NVIDIA NIM fallback, grounded school directory lookup, and ESP32 basket integration. Keep runtime credentials in ignored local configuration files.
2026-09-08 feat(basket): add R3 single-tray double-floor lock box design
    Include Blender animation, fabrication models, circuit documentation, firmware, and reproducible CAD/software validation. Record physical A4 detection and hardware qualification as pending.
    [BOM.csv, R3_Arduino_Nano_spacer.001.stl, R3_Arduino_Nano_spacer.stl, R3_BLE_3V3_spacer.001.stl, R3_BLE_3V3_spacer.stl, R3_D24V10F5_spacer.001.stl, R3_D24V10F5_spacer.stl, R3_HX711_5V_carrier_spacer.001.stl]
2026-09-09 feat(basket): add R4 automatic lid and differential paper lift
    Add a separate R4 prototype with one lid servo and two synchronised screw-drive motors. Lift the tray, then tilt it 12 degrees with the lid side lower. Sequence automatic unlocking, opening, presentation, return and relocking.
    Preserve R3. Replace its manual pocket-slide joint only in R4 with a fixed 105-degree hinge. Include editable Blender, a combined GLB animation, 52 fabrication reference STLs, rendered previews, motor calculations, wiring/interface specification and tested sequencing core.
    Verify 143 sampled poses, 121 roller-contact cases, retained R3 mesh extents, manifold exports and controller fault cases. Hardware in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
    [BOM.csv, R3_captive_front_panel.stl, R3_cell_loaded_spacer.stl, R3_fixed_electronics_deck.stl, R3_front_top_seal.stl, R3_front_wall.stl, R3_overload_stop.001.stl, R3_overload_stop.stl]
2026-09-09 feat(basket): add fixed front and rear carrying handles
    Add two rounded steel grips with under-base feet and eight M4 through-bolts. Machine matching countersunk holes in the R4 base. Keep the handles independent of the automatic lid, paper lift and weighing mechanism.
    Regenerate Blender, GLB, fabrication STLs and review images; document dimensions, hardware and assembly. Verify 143 motion samples, handle clearance against fixed components and manifold fabrication meshes. Physical carrying-load qualification remains pending.
    [BOM.csv, R3_base_255x324.stl, R4_carry_handle_front.stl, R4_carry_handle_rear.stl, smart_lock_box_r4.blend]
2026-09-09 feat(basket): replace R4 with R3 internal actuator floor lift
    Keep the R3 tray, weighing cell and manual stowing door. Fit a sourced PQ12 actuator completely inside the 255x324x108 mm enclosure, with a guided 27 mm floor lift. Add order options and links, fabrication references, rendered views and validated motion exports; distinguish CAD checks from untested firmware and physical hardware.
    [BOM.csv, L_BLE_standoff.001.stl, L_BLE_standoff.stl, L_D24V10F5_standoff.001.stl, L_D24V10F5_standoff.stl, L_DRV8876_standoff.001.stl, L_DRV8876_standoff.stl, L_HX711_standoff.001.stl]
